ItsNotDaan/BodyTempSensor/Invertory BOM.xlsx

LCSC Part Number | Manufacture Part Number | Manufacturer | Customer NO. | Package | Description | RoHS | Quantity | Unit Price($) | Ext.Price($) | Estimated lead time (business days) | Updated lead time | Date Code / Lot No.
C881688 | A2547WRB-2X3P | CJT(Changjiang Connectors) |  | Through Hole,Right Angle,P=2.54mm | Connector Header 6 position 2.54mm Pitch 3A Right Angle -40‚ÑÉ~+105‚ÑÉ | YES | 5 | 0.5219 | 2.61
C2907295 | FRC0805J102 TS | FOJAN |  | 805 | 1kŒ© ¬±5% 125mW 0805 Thick Film Resistor | YES | 100 | 0.0013 | 0.13
C103210 | RTT03103JTP | RALEC |  | 603 | 10kŒ© ¬±5% 100mW 0603 Thick Film Resistor | YES | 100 | 0.0009 | 0.09
C381115 | DC-005-5A-2.5 | XKB Connectivity |  | Through Hole | Power Barrel Connector Jack 2.5mm ID 6.5mm OD Through Hole, Right Angle | YES | 5 | 0.2796 | 1.40
C908221 | DSR1M | FUXINSEMI |  | SOD-123 | Diode 1000V 1A Surface Mount SOD-123 | YES | 100 | 0.0069 | 0.69
C134191 | K8-5851E-N1 | Korean Hroparts Elec |  | Through Hole | Pushbutton Switch Rectangular Button Through Hole | YES | 10 | 0.1816 | 1.82
C440004 | FM21X102K501PXG | PSA(Prosperity Dielectrics) |  | 805 | 1nF ¬±10% 500V Ceramic Capacitor X7R 0805 | YES | 50 | 0.009 | 0.45
C82522 | MM1Z24 | ST(Semtech) |  | SOD-123 | Zener Diode Independent 24V 500mW Surface Mount SOD-123 | YES | 50 | 0.0167 | 0.84
C351450 | AMS1117-5.0S | UMW(Youtai Semiconductor Co., Ltd.) |  | SOT-89 | Linear Voltage Regulator IC Positive Fixed 1 Output SOT-89 | YES | 5 | 0.0711 | 0.36
C602037 | CL21A226MAYNNNE | Samsung Electro-Mechanics |  | 805 | 22uF ¬±20% 25V Ceramic Capacitor X5R 0805 | YES | 20 | 0.0235 | 0.47
C83054 | 0603B104K250CT | Walsin Tech Corp |  | 603 | 100nF ¬±10% 25V Ceramic Capacitor X7R 0603 | YES | 100 | 0.0018 | 0.18
C295917 | 0402B103J500CT | Walsin Tech Corp |  | 402 | 10nF ¬±5% 50V Ceramic Capacitor X7R 0402 | YES | 100 | 0.0015 | 0.15
C369599 | 30N06 | UMW(Youtai Semiconductor Co., Ltd.) |  | TO-252 | N-Channel 60V 30A 55W Surface Mount TO-252 | YES | 5 | 0.1744 | 0.87
C104211 | RTT05302JTP | RALEC |  | 805 | 3kŒ© ¬±5% 125mW 0805 Thick Film Resistor | YES | 100 | 0.0029 | 0.29
C75856 | LMT85LP | Texas Instruments |  | TO-92 | -50‚ÑÉ~+150‚ÑÉ ¬±2.7‚ÑÉ TO-92 Analog and Digital Output RoHS | YES | 5 | 0.9514 | 4.76
C14877 | ATMEGA328P-AU | Microchip Tech |  | TQFP-32(7x7) | AVR 8 Bit 20MHz 23 TQFP-32(7x7) Microcontrollers RoHS | YES | 10 | 30864 | 30.86
C125975 | UWT1V101MCL1GS | Nichicon |  | SMD,D6.3xL7.7mm | 100uF ¬±20% 35V Aluminum Electrolytic Capacitors 1000hrs@105‚ÑÉ | YES | 5 | 0.0733 | 0.37
C110703 | PESDMC2FD18VB | Shanghai Prisemi Elec |  | DFN1006-2 | 60VC Clamp 2.5A@8/20us Ipp ESD DIODE DFN1006-2 | YES | 10 | 0.0451 | 0.45
C2904521 | HoLTT0603-1/10W-4.7K-1% | Milliohm |  | 603 | 4.7kŒ© ¬±1% 100mW 0603 Thick Film Resistor | YES | 60 | 0.0302 | 1.81
C2976072 | WS2812C-2020-V1 | Worldsemi |  | SMD,2x2mm | SMD,2x2mm LED Addressable, Specialty RoHS | YES | 200 | 0.0669 | 13.38
C3017744 | SCR0603J470R | VO |  | 603 | 100mW 470Œ© 75V Thick Film Resistor ¬±200ppm/‚ÑÉ ¬±5% 0603 Chip Resistor - Surface Mount RoHS | YES | 100 | 0.0011 | 0.11
C3016353 | SCR0603F22K | VO |  | 603 | 100mW 22kŒ© 75V Thick Film Resistor ¬±100ppm/‚ÑÉ ¬±1% 0603 Chip Resistor - Surface Mount RoHS | YES | 100 | 0.0013 | 0.13
C223907 | TYPE-C-31-M-14 | Korean Hroparts Elec |  | SMD | USB-C (USB TYPE-C) Receptacle Connector 16 Position Surface Mount | YES | 20 | 0.4519 | 9.04
C965790 | XL-1005SURC | XINGLIGHT |  | 402 | Red 625nm LED Indication - Discrete 2.3V 0402 | YES | 100 | 0.0069 | 0.69
C105620 | CC0603JRNPO9BN220 | YAGEO |  | 603 | 22pF ¬±5% 50V Ceramic Capacitor NP0 0603 | YES | 100 | 0.0023 | 0.23
C69335 | CL10A475KA8NQNC | Samsung Electro-Mechanics |  | 603 | 4.7uF ¬±10% 25V Ceramic Capacitor X5R 0603 | YES | 40 | 0.0173 | 0.69
C424093 | MCP73831T-2ACI/OT | Microchip Tech |  | SOT-23-5 | 3.75V~6V Lithium Battery 1 550mA SOT-23-5 Battery Chargers ICs RoHS | YES | 10 | 0.6523 | 6.52
C56392 | 0402B104K250NT | FH (Guangdong Fenghua Advanced Tech) |  | 402 | 100nF ¬±10% 25V Ceramic Capacitor X7R 0402 | YES | 100 | 0.0012 | 0.12
C105873 | RC0402JR-075K1L | YAGEO |  | 402 | 5.1kŒ© ¬±5% 62.5mW 0402 Thick Film Resistor | YES | 100 | 0.0006 | 0.06
C107000 | CC0402JRNPO9BN200 | YAGEO |  | 402 | 20pF ¬±5% 50V Ceramic Capacitor NP0 0402 | YES | 100 | 0.001 | 0.10
C113791 | CC0402MRX5R6BB105 | YAGEO |  | 402 | 1uF ¬±20% 10V Ceramic Capacitor X5R 0402 | YES | 100 | 0.0026 | 0.26
C135262 | SMNR4020-2.2UH | SXN(Shun Xiang Nuo Elec) |  | SMD,4x4mm | 3.4A 2.2uH ¬±20% 3.4A 46mŒ© SMD,4x4mm Fixed Inductors RoHS | YES | 10 | 0.0499 | 0.50
C141836 | TLV62569DBVR | Texas Instruments |  | SOT-23-5 | 1.5MHz Step-down type Adjustable 600mV~5.5V 2A SOT-23-5 Voltage Regulators - DC DC Switching Regulators RoHS | YES | 10 | 0.051 | 0.51
C163810 | WR04X1002FTL | Walsin Tech Corp |  | 402 | 10kŒ© ¬±1% 62.5mW 0402 Thick Film Resistor | YES | 100 | 0.0006 | 0.06
C1660 | 0603CG3R3C500NT | FH (Guangdong Fenghua Advanced Tech) |  | 603 | 3.3pF 50V Ceramic Capacitor C0G 0603 | YES | 100 | 0.0027 | 0.27
C258501 | C1005NP0100JGTS | Darfon Elec |  | 402 | 10pF ¬±5% 50V Ceramic Capacitor NP0 0402 | YES | 100 | 0.0025 | 0.25
C2827654 | USBLC6-2SC6 | TECH PUBLIC |  | SOT-23-6 | 12VC Clamp 6A Ipp ESD DIODE SOT-23-6 | YES | 10 | 0.0307 | 0.31
C2843335 | W25Q16JVUXIQ | Winbond Elec |  | USON-8-EP(2x3) | 2.7V~3.6V 16Mbit 133MHz SPI USON-8-EP(2x3) Memory (ICs) RoHS | YES | 5 | 0.4069 | 2.03
C2885592 | X252040MMB4SI | YXC Crystal Oscillators |  | SMD2520-4P | Crystal 40MHz ¬±10ppm 10pF SMD2520-4P | YES | 10 | 0.0897 | 0.90
C2913194 | ESP32-S3R8 | Espressif Systems |  | QFN-56(7x7) | -74.2dBm 150Mbps 2.412GHz~2.484GHz 2.4GHz 3V~3.6V QFN-56(7x7) RF Transceiver ICs RoHS | YES | 5 | 35962 | 17.98
C2925417 | KH-3216-H0209 | Shenzhen Kinghelm Elec |  | 1206 | RF ANTENNA Patch Surface Mount 1206 | YES | 10 | 0.0467 | 0.47
C2976072 | WS2812C-2020-V1 | Worldsemi |  | SMD,2x2mm | SMD,2x2mm LED Addressable, Specialty RoHS | YES | 40 | 0.0662 | 2.65
C2992625 | 0402X106M100CT | Walsin Tech Corp |  | 402 | 10uF ¬±20% 10V Ceramic Capacitor X5R 0402 | YES | 30 | 0.0418 | 1.25
C370234 | SDCL1608C2N0STDF | Sunlord |  | - | - | - | 50 | 0.0078 | 0.39
C413049 | ERJ2RKF22R0X | PANASONIC |  | 402 | 22Œ© 100mW Thick Film Resistor ¬±100ppm/‚ÑÉ ¬±1% 0402 Chip Resistor - Surface Mount RoHS | YES | 100 | 0.0046 | 0.46
C512395 | EVQP2P02W | PANASONIC |  | SMD,4.7x3.5mm | Tactile Switch SPST 1N 2.5mm J-Lead 4.7mm x 3.5mm Surface Mount | YES | 20 | 0.2153 | 4.31
C705662 | RT0402CRE07100KL | YAGEO |  | 402 | 100kŒ© 62.5mW 50V Thin Film Resistor ¬±50ppm/‚ÑÉ ¬±0.25% 0402 Chip Resistor - Surface Mount RoHS | YES | 20 | 0.0287 | 0.57
C82453 | GRM155R60J475ME47D | Murata Electronics |  | 402 | 4.7uF ¬±20% 6.3V Ceramic Capacitor X5R 0402 | YES | 100 | 0.0055 | 0.55
C93232 | DST310S 32.768KHz | KDS Daishinku |  | SMD3215-2P | 12.5pF SMD3215-2P Crystals RoHS | YES | 5 | 0.2609 | 1.30
C3040637 | TPMCP1702T-5002E/MB | TECH PUBLIC |  | SOT-89-3 | 5V Positive Fixed SOT-89-3 Voltage Regulators - Linear, Low Drop Out (LDO) Regulators RoHS | YES | 10 | 0.233 | 2.33
C99269 | TMP102AIDRLR | Texas Instruments |  | SOT-563 | -40‚ÑÉ~+125‚ÑÉ I2C ¬±0.5‚ÑÉ SOT-563 Analog and Digital Output RoHS | YES | 5 | 0.2658 | 1.33
C141380 | PCA9557PW,118 | NXP Semicon |  | TSSOP-16 | 8 TSSOP-16 I/O Expanders RoHS | YES | 5 | 0.6425 | 3.21
C965818 | XL-2012UWC | XINGLIGHT |  | 805 | White LED Indication - Discrete 3.3V 0805 | YES | 50 | 0.0089 | 0.45
C2837587 | KH-BNC50-3511 | Shenzhen Kinghelm Elec |  | Through Hole | Connector Receptacle BNC Female Pin 50Œ© Through Hole Right Angle | YES | 5 | 0.8258 | 4.13
C193969 | ADS1015IDGSR | Texas Instruments |  | VSSOP-10-0.5mm | I2C 2V~5.5V VSSOP-10-0.5mm Analog to Digital Converters (ADC) RoHS | YES | 5 | 10388 | 5.19
C2761457 | AS0BC21-S48BE-7H | FOXCONN |  | SMD,P=0.5mm,Surface Mount,Right Angle | 67P Surface Mount, Right Angle SMD,P=0.5mm,Surface Mount,Right Angle Centronics Connectors RoHS | YES | 5 | 0.9805 | 4.90
C2761526 | AS0BC21-S40BB-7H | FOXCONN |  | SMD,P=0.5mm,Surface Mount,Right Angle | 67P Surface Mount, Right Angle SMD,P=0.5mm,Surface Mount,Right Angle Centronics Connectors RoHS | YES | 20 | 0.3079 | 6.16
C512395 | EVQP2P02W | PANASONIC |  | SMD,4.7x3.5mm | Tactile Switch SPST 1N 2.5mm J-Lead 4.7mm x 3.5mm Surface Mount | YES | 30 | 0.2288 | 6.86
C2827654 | USBLC6-2SC6 | TECH PUBLIC |  | SOT-23-6 | 12VC Clamp 6A Ipp ESD DIODE SOT-23-6 | YES | 10 | 0.0334 | 0.33
C144198 | MCP4725A0T-E/CH | MICROCHIP |  | SOT-23-6 | 6us 2.7V~5.5V 2LSB I2C SOT-23-6 Digital to Analog Converters (DAC) RoHS | YES | 3 | 0.8004 | 2.40
C7813 | SN74LVC125APWR | TI |  | TSSOP-14 | 1.65V~3.6V 1 4 2.5ns@3.3V,50pF 40uA TSSOP-14 Buffers, Drivers, Receivers, Transceivers RoHS | YES | 5 | 0.1412 | 0.71
C393941 | TF PUSH | SHOU HAN |  | SMD | Micro SD card (TF card) Connector and Ejector Push-Push Surface Mount | YES | 10 | 0.0509 | 0.51
C2765186 | TYPE-C 16PIN 2MD(073) | SHOU HAN |  | SMD | USB-C (USB TYPE-C) Receptacle Connector 16 Position Surface Mount, Right Angle | YES | 20 | 0.0505 | 1.01
C2976072 | WS2812C-2020-V1 | Worldsemi |  | SMD,2x2mm | SMD,2x2mm LED Addressable, Specialty RoHS | YES | 50 | 0.0528 | 2.64
