ItsNotDaan/BodyTempSensor/BodyTempSens_Data.xlsx

Sheet: Parameters
Component_Value | Component_Package | Component_Voltage | Component_Current | Component_Tolerance | Component_Type | Specifications | LCSC PART # | Manufacturer_Name
1u | 0603 | 25V |  | 10% | X5R | 25V 1uF X5R ±10% 0603 | C14664 | YAGEO
10u | 0603 | 25V |  | 10% | X5R | 25V 10uF X5R ±10% 0603 | C7500379 | YAGEO
4u7 | 0603 | 25V |  | 10% | X5R | 25V 4.7uF X5R ±10% 0603 | C326580 | YAGEO
10u | 0603 | 25V |  | 10% | X5R | 25V 10uF X5R ±10% 0603 | C7500379 | YAGEO
100n | 0603 | 50V |  | 10% | X7R | 50V 100nF X7R ±10% 0603 | C14663 | YAGEO
10u | 0603 | 25V |  | 10% | X5R | 25V 10uF X5R ±10% 0603 | C7500379 | YAGEO
1u | 0603 | 25V |  | 10% | X5R | 25V 1uF X5R ±10% 0603 | C14664 | YAGEO
1u | 0603 | 25V |  | 10% | X5R | 25V 1uF X5R ±10% 0603 | C14664 | YAGEO
100n | 0603 | 50V |  | 10% | X7R | 50V 100nF X7R ±10% 0603 | C14663 | YAGEO
100n | 0603 | 50V |  | 10% | X7R | 50V 100nF X7R ±10% 0603 | C14663 | YAGEO
17/6V 5A | SOT-23-6 | 5,25V | 5A |  |  | 5A 17V 6V Unidirectional 5.25V SOT-23-6 ESD and Surge Protection | C7519 | STMicroelectronics
40V 2A | SMA(DO-214AC) | 40V |  |  |  | 40V 550mV@2A Schottky Diode | C50645 | Microdiode Semiconductor
RED | 0603 |  | 20mA |  |  | 20mA 620nm~630nm Red 120° 50mW 2.3V 0603 LED | C965799 | XINGLIGHT
RED | 0603 |  | 20mA |  |  | 20mA 620nm~630nm Red 120° 50mW 2.3V 0603 LED | C965799 | XINGLIGHT
 | SOT-23-5 |  |  |  |  | Step-down type Adjustable 600mV~5.5V 2A 2.5V~5.5V | C141836 | Texas Instruments
 | SMD-53P |  |  |  |  |  | C5736265 | Espressif Systems
 | SMD-53P |  |  |  |  |  | C5736265 | Espressif Systems
 | SMD |  | 5A |  |  | 5A USB Sinking plate 16P Female Type-C | C2835313 | XUNPU
 |  |  |  |  |  |  |  | SAMTEC
 | 0,5mm
 | 0,5mm
 | 0,5mm
2u2 | 1008 |  | 1,3A | 20% |  | 1.3A 2.2uH ±20% | C86092 | Murata Electronics
RED | 0603 | 2,3V | 20mA |  |  | 20mA 620nm~630nm Red 120° 50mW 2.3V 0603 LED | C965799 | XINGLIGHT
RED | 0603 | 2,3V | 20mA |  |  | 20mA 620nm~630nm Red 120° 50mW 2.3V 0603 LED | C965799 | XINGLIGHT
5k1 | 0603 | 75V |  | 100ppm |  | 5k1Ω 0603 75V ±100ppm | C105580 | YAGEO
5k1 | 0603 | 75V |  | 100ppm |  | 5k1Ω 0603 75V ±100ppm | C105580 | YAGEO
470 | 0603 | 75V |  | 100ppm |  | 470Ω 0603 75V ±100ppm | C114669 | YAGEO
470 | 0603 | 75V |  | 100ppm |  | 470Ω 0603 75V ±100ppm | C114669 | YAGEO
453k | 0603 | 75V |  | ±1% |  | 453kΩ 0603 75V ±100ppm ±1% | C3013202 | UNI-ROYAL(Uniroyal Elec)
100k | 0603 | 75V |  | 100ppm |  | 100kΩ 0603 75V ±100ppm | C14675 | YAGEO
10k | 0603 | 75V |  | 100ppm |  | 10kΩ 0603 75V ±100ppm | C98220 | YAGEO
10k | 0603 | 75V |  | 100ppm |  | 10kΩ 0603 75V ±100ppm | C98220 | YAGEO
BTN | SMD | 12V | 50mA |  |  | 50mA 6mm 50,000 Times 260gf 12V 3.6mm 2.5mm | C318938 | XKB Connection
BTN | SMD | 12V | 50mA |  |  | 50mA 6mm 50,000 Times 260gf 12V 3.6mm 2.5mm | C318938 | XKB Connection
 | SMD,1x1mm |  |  |  |  | SMD,1x1mm RGB LEDs(Built-in IC) ROHS | C5349953 | XINGLIGHT

Sheet: Final Parameters
Identifier | Component_Value | Component_Voltage | Component_Current | Component_Tolerance | Component_Type | Specifications |  | LCSC PART # | Component_Package | Manufacturer_Name
C1 | 1u | 25V |  | 0.1 | X5R | 25V 1uF X5R ±10% 0603 | CC0603KRX5R8BB105 | C14664 | 0603 | YAGEO
C2 | 10u | 25V |  | 0.1 | X5R | 25V 10uF X5R ±10% 0603 | CC0603KRX5R8BB106 | C7500379 | 0603 | YAGEO
C3 | 4u7 | 25V |  | 0.1 | X5R | 25V 4.7uF X5R ±10% 0603 | CC0603KRX5R8BB475 | C326580 | 0603 | YAGEO
C4 | 10u | 25V |  | 0.1 | X5R | 25V 10uF X5R ±10% 0603 | CC0603KRX5R8BB106 | C7500379 | 0603 | YAGEO
C5 | 100n | 50V |  | 0.1 | X7R | 50V 100nF X7R ±10% 0603 | CC0603KRX7R9BB104 | C14663 | 0603 | YAGEO
C6 | 10u | 25V |  | 0.1 | X5R | 25V 10uF X5R ±10% 0603 | CC0603KRX5R8BB106 | C7500379 | 0603 | YAGEO
C7 | 1u | 25V |  | 0.1 | X5R | 25V 1uF X5R ±10% 0603 | CC0603KRX5R8BB105 | C14664 | 0603 | YAGEO
C8 | 1u | 25V |  | 0.1 | X5R | 25V 1uF X5R ±10% 0603 | CC0603KRX5R8BB105 | C14664 | 0603 | YAGEO
C9 | 100n | 50V |  | 0.1 | X7R | 50V 100nF X7R ±10% 0603 | CC0603KRX7R9BB104 | C14663 | 0603 | YAGEO
C10 | 100n | 50V |  | 0.1 | X7R | 50V 100nF X7R ±10% 0603 | CC0603KRX7R9BB104 | C14663 | 0603 | YAGEO
D1 | 17/6V 5A | 5,25V | 5A |  |  | 5A 17V 6V Unidirectional 5.25V SOT-23-6 ESD and Surge Protection | USBLC6-2SC6 | C7519 | SOT-23-6 | STMicroelectronics
D2 | 550mV | 40V | 2A |  |  | 40V 550mV@2A Schottky Diode | SS24 | C50645 | DO-214AC | Microdiode Semiconductor
D3 | RED |  | 20mA |  |  | 20mA 620nm~630nm Red 120° 50mW 2.3V 0603 LED | XL-1608SURC-06 | C965799 | 0603 | XINGLIGHT
D4 | RED |  | 20mA |  |  | 20mA 620nm~630nm Red 120° 50mW 2.3V 0603 LED | XL-1608SURC-06 | C965799 | 0603 | XINGLIGHT
IC1 |  |  |  |  |  | Step-down type Adjustable 600mV~5.5V 2A 2.5V~5.5V | TLV62569DBVR | C141836 | SOT-23-5 | Texas Instruments
IC2A |  |  |  |  |  | SMD-53P WiFi Modules ROHS | ESP32-C6-MINI-1-N4 | C5736265 | SMD-53P | Espressif Systems
IC2B |  |  |  |  |  | SMD-53P WiFi Modules ROHS | ESP32-C6-MINI-1-N4 | C5736265 | SMD-53P | Espressif Systems
J1 |  |  | 5A |  |  | 5A USB Sinking plate 16P Female Type-C | TYPEC-302-BRP16SC16 | C2835313 | SMD | XUNPU
J2 |  |  |  |  |  |  | SQW-104-01-F-D-VS-P |  |  | SAMTEC
JP1 |  |  |  |  |  |  |  |  | 0,5mm
JP2 |  |  |  |  |  |  |  |  | 0,5mm
JP3 |  |  |  |  |  |  |  |  | 0,5mm
L1 | 2u2 |  | 1,3A | 0.2 |  | 1.3A 2.2uH ±20% | LQM2HPN2R2MG0L | C86092 | 1008 | Murata Electronics
LED1 |  |  |  |  |  | SMD,1x1mm RGB LEDs(Built-in IC) ROHS | XL-1010RGBC-WS2812B | C5349953 | SMD,1x1mm | XINGLIGHT
LED2 |  |  |  |  |  | SMD,1x1mm RGB LEDs(Built-in IC) ROHS | XL-1010RGBC-WS2812B | C5349953 | SMD,1x1mm | XINGLIGHT
R1 | 5k1 | 75V |  | ±1% |  | 5k1Ω 0603 75V ±100ppm | RC0603FR-075K1L | C105580 | 0603 | YAGEO
R2 | 5k1 | 75V |  | ±1% |  | 5k1Ω 0603 75V ±100ppm | RC0603FR-075K1L | C105580 | 0603 | YAGEO
R3 | 470 | 75V |  | 100ppm |  | 470Ω 0603 75V ±100ppm | RC0603FR-07470RL | C114669 | 0603 | YAGEO
R4 | 470 | 75V |  | 100ppm |  | 470Ω 0603 75V ±100ppm | RC0603FR-07470RL | C114669 | 0603 | YAGEO
R5 | 453k | 75V |  | ±1% |  | 453kΩ 0603 75V ±100ppm ±1% | FRC0603F4533TS | C3013202 | 0603 | UNI-ROYAL(Uniroyal Elec)
R6 | 100k | 75V |  | 100ppm |  | 100kΩ 0603 75V ±100ppm | RC0603FR-07100KL | C14675 | 0603 | YAGEO
R7 | 10k | 75V |  | 100ppm |  | 10kΩ 0603 75V ±100ppm | RC0603FR-0710KL | C98220 | 0603 | YAGEO
R8 | 10k | 75V |  | 100ppm |  | 10kΩ 0603 75V ±100ppm | RC0603FR-0710KL | C98220 | 0603 | YAGEO
S1 |  | 12V | 50mA |  |  | 50mA 6mm 50,000 Times 260gf 12V 3.6mm 2.5mm | TS-1101-C-W | C318938 | SMD | XKB Connection
S2 |  | 12V | 50mA |  |  | 50mA 6mm 50,000 Times 260gf 12V 3.6mm 2.5mm | TS-1101-C-W | C318938 | SMD | XKB Connection
TP1
TP2
TP3
TP4
TP5
 |  |  |  |  |  | Power Rail: | Component name: | LCSC PART #
 |  |  |  |  |  | VBUS | USBLC6-2SC6 | C7519
 |  |  |  |  |  | VBUS | SS24 | C50645
 |  |  |  |  |  | 5V | XL-1608SURC-06 | C965799
 |  |  |  |  |  | 3V3 | XL-1608SURC-06 | C965799
 |  |  |  |  |  | Vbus to 3v3 | TLV62569DBVR | C141836
 |  |  |  |  |  | 3V3 | ESP32-C6-MINI-1-N4 | C5736265
 |  |  |  |  |  | 3V3 | XL-1010RGBC-WS2812B | C5349953
 |  |  |  |  |  | 3V3 | XL-1010RGBC-WS2812B | C5349953

Sheet: Power
Voltage Rail (V) | Part | Current (A) | TLV62569DBVR |  |  |  | Wrong Calculations |  |  |  |  |  |  |  |  | Correct Calculations
VBUS | USBLC6-2SC6 | - |  |  |  |  | Power Rail: | Component name: | Ityp | Imax | Pmax |  |  |  |  | Power Rail: | Component name: | Ityp | Imax | Pmax
5 | HLK-LD2410C | 0.20 | R2 calculation |  | IL(max) Formula |  | 5 | USBLC6-2SC6 | 0.01 |  | 0.00 | Rail Name | Voltage (V) | Load Typ | Load Max | 5 | USBLC6-2SC6 | 0.01 |  | 0.00 | Rail Name | Voltage (V) | Load Typ | Load Max
5 | HLK-LD2411 | 0.05 | Vfb | 0.6 | Fsw | 1500000 | 5 | SS24 | - |  | 0.00 | VBUS | 5 | 860mA | 1,18A | 5 | SS24 | - |  | 0.00 | VBUS | 5 | 670mA | 920A
5 | HLK-LD2450 | 0.03 | R2 | 100000 | L | 2.2e-06 | 5 | HLK-LD2450 | 0.20 | 0.30 |  | +5V | 5 | 860mA | 1,18A | 5 | HLK-LD2450 | 0.20 | 0.30 |  | +5V | 5 | 670mA | 920A |  | Start Values |  | Iin | 0.6038297872
5 | HLK-LD2420 | 0.10 | Vout | 3.3 | Vin | 5 | 5 | XL-1608SURC-06 | 0.02 | 0.02 | 0.10 | +3V3 | 3.3 | 640mA | 860mA | 5 | XL-1608SURC-06 | 0.02 | 0.02 | 0.10 | +3V3 | 3.3 | 640mA | 860mA |  | Name | Value
5 | ME73MS01 | 0.05 |  |  | Vout | 3.318 | 5 | TLV62569DBVR | 0.64 | 0.86 | 4.30 |  |  |  |  | 5 | TLV62569DBVR | 0.45 | 0.60 | 3.00 |  |  |  |  |  | Vin | 5
5 | DFRobot SEN0395 | 0.15 |  |  | IL(max) | 1.3 |  |  | 0.86 | 1.18 |  |  |  |  |  |  |  | 0.67 | 0.92 |  |  |  |  |  |  | Vout | 3.3
5 | WS2812C-2020-V1 | 0.06 |  |  |  |  |  |  |  |  |  |  |  |  |  |  |  |  |  |  |  |  |  |  |  | Iout | 0.86
5 | XL-1608SURC-06 | 0.02 | R1 = | 450000 |  |  | 3,3 | XL-1608SURC-06 | 0.02 | 0.02 | 0.07 |  |  |  |  | 3,3 | XL-1608SURC-06 | 0.02 | 0.02 | 0.07 |  |  |  |  |  | Efficiency | 94%
3.3 | ESP32-C6-MINI-1-N4 | 0.50 |  |  | Top | 5.580876 | 3,3 | ESP32-C6-MINI-1-N4 | 0.50 | 0.60 | 1.98 |  |  |  |  | 3,3 | ESP32-C6-MINI-1-N4 | 0.50 | 0.60 | 1.98 |  |  |  |  |  | Pin | 3.019148936
3.3 | MS72SF1 | 0.15 | Vout calculation] |  | Bottom | 16.5 | 3,3 | XL-1010RGBC-WS2812B | 0.06 | 0.12 | 0.40 |  |  |  |  | 3,3 | XL-1010RGBC-WS2812B | 0.06 | 0.12 | 0.40
 | TLV62569DBVR |  | Chosen R1: | 453000 | IL = | 0.3382349091 | 3,3 | XL-1010RGBC-WS2812B | 0.06 | 0.12 | 0.40 |  |  |  |  | 3,3 | XL-1010RGBC-WS2812B | 0.06 | 0.12 | 0.40 | TYPICAL LOAD |  |  |  |  |  |  |  |  | TYPICAL LOAD
 |  |  |  |  |  |  |  |  | 0.64 | 0.86 |  |  |  |  |  |  |  | 0.64 | 0.86 |  | OUT |  |  |  | IN |  |  |  |  | OUT |  |  |  | IN
 |  |  |  |  | Iout(max) Formula |  |  |  |  |  |  |  |  |  |  |  |  |  |  |  | Converter (VOUT) | Converter (IOUT) | Converter (POUT) | Efficiency (Datasheet) | Converter (VIN) | Converter (PIN) | Converter (I_IN Line) |  |  | Converter (VOUT) | Converter (IOUT) | Converter (POUT) | Efficiency (Datasheet) | Converter (VIN) | Converter (PIN) | Converter (I_IN Line)
 |  |  |  |  | IL(max) | 1.3 |  |  |  |  |  |  |  |  |  |  |  |  |  |  | 3.3V | 0.64A | 2.112W | 94.00% | 5.0V | 2.24681W | 0.44936A |  |  | 3.3V | 0.64A | 2.112W | 94.00% | 5.0V | 2.24681W | 0.44936A
 |  |  | Vout = | 3.318
 |  |  |  |  | IL = | 1.130882545 |  |  |  |  |  |  |  |  |  |  |  |  |  |  | MAX LOAD |  |  |  |  |  |  |  |  | MAX LOAD
 |  |  |  |  |  |  |  |  |  |  |  |  |  |  |  |  |  |  |  |  | OUT |  |  |  | IN |  |  |  |  | OUT |  |  |  | IN
 |  |  |  |  |  |  |  |  |  |  |  |  |  |  |  |  |  |  |  |  | Converter (VOUT) | Converter (IOUT) | Converter (POUT) | Efficiency (Datasheet) | Converter (VIN) | Converter (PIN) | Converter (I_IN Line) |  |  | Converter (VOUT) | Converter (IOUT) | Converter (POUT) | Efficiency (Datasheet) | Converter (VIN) | Converter (PIN) | Converter (I_IN Line)
 |  |  |  |  |  |  |  |  |  |  |  |  |  |  |  |  |  |  |  |  | 3.3V | 0.86A | 2.838W | 94.00% | 5.0V | 3.01915W | 0.60383A |  |  | 3.3V | 0.86A | 2.838W | 94.00% | 5.0V | 3.01915W | 0.60383A
 |  |  |  |  |  |  |  |  |  |  |  |  |  |  |  |  |  |  |  |  | Start Values
 |  |  |  |  |  |  |  |  |  |  |  |  |  |  |  |  |  |  |  |  | Name | Value
 |  |  |  |  |  |  |  |  |  |  |  |  |  |  |  |  |  |  |  |  | Vin | +5V
 |  |  |  |  |  |  |  |  |  |  |  |  |  |  |  |  |  |  |  |  | Vout | +3V3
 |  |  |  |  |  |  |  |  |  |  |  |  |  |  |  |  |  |  |  |  | Iout | 860mA
 |  |  |  |  |  |  |  |  |  |  |  |  |  |  |  |  |  |  |  |  | Efficiency | 90%
 |  |  |  |  |  |  |  |  |  |  |  |  |  |  |  |  |  |  |  |  | Pin | #VALUE!

Sheet: Sheet1
Name: | Typ: | Max: | Standby: | Battery capacity: | 0.5 |  | Typ: | Max: | Standby:
USB-C | 0 |  |  |  |  | Hours: | 60.78842588 | 32.6306859 | 3149.606299
MCP73833 | 2.5e-07 | 2e-06 | 2.5e-07 |  |  | Days: | 2.532851078 | 1.359611912 | 131.2335958
TLV62568DBVR | 3.5e-05 | 3.5e-05 | 3.5e-05
NRF52840-QIAA-F-R7 | 1.3e-05 | 2.6e-05 | 3e-06
MCP6001-OT | 0.00011 | 0.00016 | 0.00011 |  |  | Active: 8.23 mA × 1h = 8.23 mAh
WS2812C-2020-V1 | 0.008 | 0.015 | 1e-05 |  |  | Standby: 0.159 mA × 23h = 3.66 mAh
MAX30208CLB+T | 6.7e-05 | 0.0001 | 5e-07 |  |  | Total per day: ~12 mAh
 | Typ: | Max: | Standby: |  |  | Days: | 41.66666667
Total: | 0.00822525 | 0.015323 | 0.00015875
Battery: 3.7V 500mAh
Name: | Typ: | Max: | Standby: | Battery capacity: | 0.5 |  | Typ: | Max: | Standby:
USB-C | 0 |  |  |  |  | Hours: | 2219.755827 | 32.6306859 | 9302.325581
MCP73833 | 2.5e-07 | 2e-06 | 2.5e-07 |  |  | Days: | 92.48982612 | 1.359611912 | 387.5968992
TLV62568DBVR | 3.5e-05 | 3.5e-05 | 3.5e-05
NRF52840-QIAA-F-R7 | 1.3e-05 | 2.6e-05 | 3e-06
MCP6001-OT | 1e-05 | 0.00016 | 1e-05 |  |  | Active: 8.23 mA × 1h = 8.23 mAh
WS2812C-2020-V1 | 0.0001 | 0.015 | 5e-06 |  |  | Standby: 0.159 mA × 23h = 3.66 mAh
MAX30208CLB+T | 6.7e-05 | 0.0001 | 5e-07 |  |  | Total per day: ~12 mAh
 | Typ: | Max: | Standby: |  |  | Days: | 41.66666667
Total: | 0.00022525 | 0.015323 | 5.375e-05
Battery: 3.7V 500mAh

Sheet: Pricelist
Body Temperature Sensor — Pricelist (LCSC)
Source: lcsc.com — prices as of Jun 2026, unit price at qty 1. Source URLs in cell comments.
Line # | MPN | Description | LCSC Part # | Qty | Unit Price (USD) | Extended Price (USD) | In Stock? | Notes
1 | CC0402KRX5R6BB104 | 100nF 0402 MLCC | C129131 | 21 | €0.0010 | €0.0210 | Yes | YAGEO, 10V X5R
2 | CC0402KRX5R8BB105 | 1µF 0402 MLCC | C326568 | 7 | €0.0020 | €0.0140 | Yes | YAGEO, 25V X5R
3 | USBLC6-2SC6 | ESD protection | C7519 | 1 | €0.0780 | €0.0780 | Yes | ST, SOT-23-6, 45,720 pcs
4 | USB4105-GF-A | USB-C receptacle | C3020560 | 1 | €0.5480 | €0.5480 | Yes | GCT, 16P top-mount
5 | 52271-0479 | 1mm FPC 4-ckt connector | N/A | 1 | €0.0000 | €0.0000 | No (LCSC) | ⚠ Not at LCSC — order from Mouser/Digi-Key
6 | SMNR4020-2.2UH | 2.2µH 4020 inductor (alt) | C135262 | 1 | €0.0250 | €0.0250 | Yes | Alt for Würth 74404020022 (same 4020 pkg, 2.2µH)
7 | RC0402FR-0710KL | 10kΩ 0402 resistor | C60490 | 8 | €0.0005 | €0.0040 | Yes | YAGEO 1%, 709,100 pcs
8 | EVQP2B02B | Tactile switch | C713480 | 1 | €0.7950 | €0.7950 | Yes | Panasonic EVQP2, 1,317 pcs
9 | NRF52840-QIAA-R | nRF52840 BLE SoC | C190794 | 1 | €4.1500 | €4.1500 | Yes | Nordic, AQFN-73
10 | TMP117MAIDRVR | Precision temp sensor | C2803242 | 1 | €1.0300 | €1.0300 | Yes | TI, 2,450 pcs; T-suffix OOS → use R-suffix
11 | MCP73833-AMI/UN | Li-Ion charger | C511281 | 1 | €0.0000 | €0.0000 | No (LCSC) | ⚠ OOS at LCSC — order from Mouser/Digi-Key (~$0.60)
12 | TLV62568DBVR | Buck converter 1A | C163219 | 1 | €0.3500 | €0.3500 | Yes | TI, SOT-23-5
13 | MCP6001T-I/OT | Op-amp single | C116490 | 1 | €0.1230 | €0.1230 | Yes | Microchip, 23,160 pcs
14 | X322525MOB4SI | Crystal 32MHz 3225 | C9006 | 1 | €0.0370 | €0.0370 | Yes | YXC, SMD-3225 4P
15 | WS2812C-2020-V1 | RGB LED addressable | C2976072 | 1 | €0.0550 | €0.0550 | Yes | Worldsemi, 204,310 pcs
TOTAL (LCSC-sourced lines only) |  |  |  |  |  | €7.2300
TOTAL (all lines, unit qty) |  |  |  |  |  | €7.2300

Sheet: BOM
Reference | Qty | Value | Footprint | Datasheet | LCSC PART # | Manufacturer_Name | Manufacturer_Part_Number | Description | Gecheckt | LCSC Voorraad / Prijs (USD)
ACT1 | 1 | SW_ACT | PCB_Lib_ItsNotDaan:SW_SPST_EVQP2 |  | C512395 | PANASONIC | EVQP2P02W | 20mA 4.7mm 100MŒ© 1,000,000 Times 1N 15V 3.5mm 2.5mm Rectangle button | Ja | C512395 | 174k stk | $0.11
ANT1 | 1 | KH-3216-H0209 | PCB_Lib_ItsNotDaan:ANTC3216X140N | https://www.johansontechnology.com/datasheets/2450AT18B100/2450AT18B100.pdf | C2925417 | Shenzhen Kinghelm Elec | KH-3216-H0209 | 1206 Antennas | Ja | C2925417 | op voorraad | $0.06
C1 | 1 | 1u | Capacitor_SMD:C_0402_1005Metric_Pad0.74x0.62mm_HandSolder |  | C113791 | KDS Daishinku | CC0402MRX5R6BB105 | 10V 1uF X5R ¬±20% 0403 | Ja | C113791 | 500k+ stk | $0.003
C11,C17 | 2 | 4u7 | Capacitor_SMD:C_0402_1005Metric_Pad0.74x0.62mm_HandSolder |  | C82453 | Murata Electronics | GRM155R60J475ME47D | 6.3V 4.7uF X5R ¬±20% 0402 | Ja | C82453 | 100k+ stk | $0.007
C18 | 1 | 390n | Capacitor_SMD:C_0402_1005Metric_Pad0.74x0.62mm_HandSolder |  |  |  |  |  | Nee | Niet op LCSC — zoek 0402 390nF X5R elders
C19 | 1 | 10u | Capacitor_SMD:C_0402_1005Metric_Pad0.74x0.62mm_HandSolder |  | C2992625 | FH (Guangdong Fenghua Advanced Tech) | 0402X106M100CT | 10V 10uF X5R ¬±20% 0402 | Ja | C2992625 | 300k+ stk | $0.005
C2 | 1 | 1u | Capacitor_SMD:C_0504_1310Metric_Pad0.83x1.28mm_HandSolder |  |  |  |  | Unpolarized capacitor | Nee | Niet op LCSC — zie KiCad voetafdruk
C27 | 1 | 10n | Capacitor_SMD:C_0402_1005Metric_Pad0.74x0.62mm_HandSolder |  |  |  |  | 25V 10nF X5R ¬±10% 0402 | Ja | C295917 | 1M+ stk | $0.0006
C28,C30 | 2 | 2u2 | Capacitor_SMD:C_0402_1005Metric_Pad0.74x0.62mm_HandSolder |  | C295941 | Walsin Tech Corp | 0402X225K100CT | 2.2uF ±10% 10V X5R 0402 | Nee | C295941 | op voorraad | $0.006
C29 | 1 | 2n2 | Capacitor_SMD:C_0402_1005Metric_Pad0.74x0.62mm_HandSolder |  | C106861 | YAGEO | CC0402KRX7R9BB222 | 2.2nF ±10% 50V X7R 0402 | Nee | C106861 | op voorraad | $0.0015
C3,C5,C7,C10,C12,C14,C22,C23,C24,C25,C26 | 11 | 100n | Capacitor_SMD:C_0402_1005Metric_Pad0.74x0.62mm_HandSolder |  | C361203 | YAGEO | C1005X5R1E104KT000E | 25V 100nF X5R ¬±10% 0402 | Ja | C361203 | op voorraad | $0.003
C4 | 1 | 1p5 | Capacitor_SMD:C_0402_1005Metric_Pad0.74x0.62mm_HandSolder |  |  |  |  | 50V 1.5pF 0402 | Nee | Niet op LCSC — 1.5pF NP0 0402 zeldzaam
C6,C9 | 2 | 12p | Capacitor_SMD:C_0402_1005Metric_Pad0.74x0.62mm_HandSolder |  | C106201 | YAGEO | CC0402JRNPO9BN120 | 12pF ±5% 50V NP0 0402 | Nee | C106201 | op voorraad | $0.0006
C8 | 1 | 2p | Capacitor_SMD:C_0402_1005Metric_Pad0.74x0.62mm_HandSolder |  | CC0402BRNPO9BN2R0 | YAGEO | CC0402BRNPO9BN2R0 | 2pF ±0.1pF 50V NP0 0402 (niet op LCSC, zie Farnell) | Nee | Geen LCSC C# — bestellen bij Farnell/TME
D1,D2,D3 | 3 | LED | LED_SMD:LED_0603_1608Metric_Pad1.05x0.95mm_HandSolder |  |  |  |  | Light emitting diode | Nee | C965790 | op voorraad | $0.006
IC3 | 1 | TMP117MAIDRVR | LibLoader:SON65P200X200X80-7N | http://www.ti.com/lit/ds/symlink/tmp117.pdf | C2803242 | Texas Instruments | TMP117MAIDRVR | ±0.1°C I2C WSON-6-EP(2x2) Temperature Sensor | Nee | C2803242 | 287 stk | $1.03
IC4,IC5,IC6 | 3 | TMP117MAIDRVT | LibLoader:SON65P200X200X80-7N | http://www.ti.com/lit/ds/symlink/tmp117.pdf | C2803242 | Texas Instruments | TMP117MAIDRVR | ±0.1°C I2C WSON-6-EP(2x2) Temperature Sensor (MAIDRVT obsoleet) | Nee | C2803242 | 287 stk | $1.03 (MAIDRVT obsoleet)
IC7 | 1 | NRF54L15-QFAA-R | LibLoader:QFN40P600X600X95-49N | https://docs-be.nordicsemi.com/bundle/ps_nrf54L15/page/pdf/nRF54L15_nRF54L10_nRF54L05_Datasheet_v0.8.pdf | C42458750 | Nordic Semiconductor | NRF54L15-QFAA-R | 2.4GHz BLE/Thread/Zigbee SoC QFN-48 1.5MB NVM | Nee | C42458750 | op voorraad | $2.36
J1 | 1 | USB_C_Receptacle_USB2.0 | Connector_USB:USB_C_Receptacle_GCT_USB4105-xx-A_16P_TopMnt_Horizontal | https://www.usb.org/sites/default/files/documents/usb_type-c.zip | C223907 |  |  | USB 2.0-only Type-C Receptacle connector | Nee | C223907 | op voorraad | $0.10
J2 | 1 | TC2030 | Connector:Tag-Connect_TC2030-IDC-NL_2x03_P1.27mm_Vertical | https://www.tag-connect.com/wp-content/uploads/bsk-pdf-manager/2019/12/TC2030-IDC-NL-Datasheet-Rev-B.pdf |  |  |  | Tag-Connect‚Äôs 6-pins connector | Nee | TC2030 — order bij Digikey/Mouser
J3 | 1 | BAT | Connector_PinSocket_2.54mm:PinSocket_1x02_P2.54mm_Vertical |  |  |  |  | Generic connector, single row, 01x02, script generated (kicad-library-utils/schlib/autogen/connector/) | Nee | BAT connector — type onbekend
J6 | 1 | Conn_02x05_Odd_Even | Connector_PinHeader_1.27mm:PinHeader_2x05_P1.27mm_Vertical |  |  |  |  | Generic connector, double row, 02x05, odd/even pin numbering scheme (row 1 odd numbers, row 2 even numbers), script generated (kicad-library-utils/schlib/autogen/connector/) | Nee | Conn 2x5 — type onbekend
L1,L4 | 2 | 3.5nH | Inductor_SMD:L_0201_0603Metric |  |  |  | LQP03HQ3N5B02 | 3.5 nH 0402 | Nee | 3.5nH inductor — niet op LCSC
L2 | 1 | 2u2 | Inductor_SMD_Wurth:L_Wurth_WE-LQSH-4020 |  | C135262 | SXN(Shun Xiang Nuo Elec) | SMNR4020-2.2UH | 3.4A 2.2uH ¬±20% 3.4A SMD,4x4x2mm Power Inductors ROHS | Ja | C135262 | op voorraad | $0.08
L3 | 1 | 2.7nH | Inductor_SMD:L_0201_0603Metric |  |  |  | LQP03HQ2N7B02 | 2.7 nH 0402 | Nee | 2.7nH inductor — niet op LCSC
L5 | 1 | 4u7 | Inductor_SMD:L_0201_0603Metric |  |  |  |  | 4.7 nH 0402 | Nee | 4.7uH inductor — niet op LCSC
LED1 | 1 | WS2812C-2020-V1 | PCB_Lib_ItsNotDaan:WS2812C2020 | http://www.world-semi.com/DownLoadFile/139 | C2976072 | Worldsemi | WS2812C-2020 | Intelligent control LED integrated light source | Ja | C2976072 | 500k+ stk | $0.009
Q1,Q2 | 2 | NMOS |  | https://ngspice.sourceforge.io/docs/ngspice-html-manual/manual.xhtml#cha_MOSFETs | C20917 | AOS | AO3400A | 30V 5.7A N-ch MOSFET SOT-23 | Nee | C20917 | 174k stk | $0.04
R1,R2,R26,R27 | 4 | 5k1 | Resistor_SMD:R_0402_1005Metric_Pad0.72x0.64mm_HandSolder |  | C105873 |  |  | Resistor | Ja | C105873 | 300k+ stk | $0.0005
R11 | 1 | 68k | Resistor_SMD:R_0402_1005Metric_Pad0.72x0.64mm_HandSolder |  | C238338 | YAGEO | RC0402FR-0768KL | 68kΩ ±1% 62.5mW 0402 Thick Film Resistor | Nee | C238338 | op voorraad | $0.0005
R13,R14,R19 | 3 | 100k | Resistor_SMD:R_0402_1005Metric_Pad0.72x0.64mm_HandSolder |  | C705662 | YAGEO | RT0402CRE07100KL | 100kŒ© 0402 50V ¬±50ppm | Ja | C705662 | op voorraad | $0.0005
R17 | 1 | 82k | Resistor_SMD:R_0402_1005Metric_Pad0.72x0.64mm_HandSolder |  | C137932 | YAGEO | RC0402FR-0782KL | 82kΩ ±1% 62.5mW 0402 Thick Film Resistor | Nee | C137932 | 142k stk | $0.0003
R18 | 1 | 450k | Resistor_SMD:R_0402_1005Metric_Pad0.72x0.64mm_HandSolder |  | C5159688 | FOJAN | FRC0402F4503TS | 450kŒ© 0402 50V 62,5mW ¬±100ppm | Ja | C5159688 | op voorraad | $0.003
R21,R23,R28 | 3 | 180k | Resistor_SMD:R_0402_1005Metric_Pad0.72x0.64mm_HandSolder |  | C138046 | YAGEO | RC0402FR-07180KL | 180kΩ ±1% 62.5mW 0402 Thick Film Resistor | Nee | C138046 | op voorraad | $0.0006
R22 | 1 | 47k | Resistor_SMD:R_0402_1005Metric_Pad0.72x0.64mm_HandSolder |  | C93943 | YAGEO | RC0402FR-0747KL | 47kΩ ±1% 62.5mW 0402 Thick Film Resistor | Nee | C93943 | 1,376k stk | $0.0003
R3,R12 | 2 | 22R | Resistor_SMD:R_0402_1005Metric_Pad0.72x0.64mm_HandSolder |  | C413049 | Espressif Systems | ERJ2RKF22R0X | 22Œ© 0402 50V 100mW ¬±100ppm | Ja | C413049 | op voorraad | $0.004
R4,R5,R6 | 3 | 470 | Resistor_SMD:R_0402_1005Metric_Pad0.72x0.64mm_HandSolder |  | C3017744 | VO | SCR0603J470R | 470Ω ±5% 100mW 0603 (uit inventory) | Nee | C3017744 | op voorraad | $0.002
R8,R10,R20,R25 | 4 | 10k | Resistor_SMD:R_0402_1005Metric_Pad0.72x0.64mm_HandSolder |  | C163810 | Walsin Tech Corp | WR04X1002FTL | 10kŒ© 0402 50V 62,5mW ¬±100ppm | Ja | C163810 | op voorraad | $0.0005
R9 | 1 | 1k | Resistor_SMD:R_0402_1005Metric_Pad0.72x0.64mm_HandSolder |  | C106235 | YAGEO | RC0402FR-071KL | 1kΩ ±1% 62.5mW 0402 Thick Film Resistor | Nee | C106235 | 597k stk | $0.0005
TP1,TP2,TP3,TP4 | 4 | TestPoint | TestPoint:TestPoint_Pad_D1.0mm |  |  |  |  | test point | Nee | Testpunten — geen component nodig
U2 | 1 | USBLC6-2SC6 | Package_TO_SOT_SMD:SOT-23-6 | https://www.st.com/resource/en/datasheet/usblc6-2.pdf | C2827654 |  |  | Very low capacitance ESD protection diode, 2 data-line, SOT-23-6 | Ja | C2827654 | op voorraad | $0.007
U3 | 1 | MCP73833-xxx-UN | Package_SO:MSOP-10_3x3mm_P0.5mm | https://ww1.microchip.com/downloads/aemDocuments/documents/OTH/ProductDocuments/DataSheets/22005b.pdf | C424093 |  |  | Stand-Alone Linear Li-Ion / Li-Polymer Charge Management Controller, MSOP-10 | Ja | C424093 | op voorraad | $0.09
U4 | 1 | TLV62568DBVR | Package_TO_SOT_SMD:SOT-23-5 | http://www.ti.com/lit/ds/symlink/tlv62568.pdf | C163219 | Texas Instruments | TLV62568DBVR | 5.5V 1A SOT-23-5 DC-DC Converters RoHS | Ja | C163219 | op voorraad | $0.06
U5 | 1 | MCP6001-OT | Package_TO_SOT_SMD:SOT-23-5 | https://ww1.microchip.com/downloads/en/DeviceDoc/MCP6001-1R-1U-2-4-1-MHz-Low-Power-Op-Amp-DS20001733L.pdf | C116490 | Microchip | MCP6001T-I/OT | 1MHz 1.8V~6V Single Op-Amp SOT-23-5 | Nee | C116490 | 77k stk | $0.12
Y1 | 1 | 32MHz | Crystal:Crystal_SMD_3225-4Pin_3.2x2.5mm |  | C113671 | YXC | X322532MMB4SI | 32MHz ±10ppm 10pF SMD3225-4P Crystal | Nee | C113671 | op voorraad | $0.037

Sheet: Inventory
LCSC Part Number | Manufacture Part Number | Manufacturer | Customer NO. | Package | Description | RoHS | Quantity | Unit Price($) | Ext.Price($) | Estimated lead time (business days) | Updated lead time | Date Code / Lot No.
C881688 | A2547WRB-2X3P | CJT(Changjiang Connectors) |  | Through Hole,Right Angle,P=2.54mm | Connector Header 6 position 2.54mm Pitch 3A Right Angle -40‚ÑÉ~+105‚ÑÉ | YES | 5 | 0.5219 | 2.61
C2907295 | FRC0805J102 TS | FOJAN |  | 805 | 1kŒ© ¬±5% 125mW 0805 Thick Film Resistor | YES | 100 | 0.0013 | 0.13
C103210 | RTT03103JTP | RALEC |  | 603 | 10kŒ© ¬±5% 100mW 0603 Thick Film Resistor | YES | 100 | 0.0009 | 0.09
C381115 | DC-005-5A-2.5 | XKB Connectivity |  | Through Hole | Power Barrel Connector Jack 2.5mm ID 6.5mm OD Through Hole, Right Angle | YES | 5 | 0.2796 | 1.40
C908221 | DSR1M | FUXINSEMI |  | SOD-123 | Diode 1000V 1A Surface Mount SOD-123 | YES | 100 | 0.0069 | 0.69
C134191 | K8-5851E-N1 | Korean Hroparts Elec |  | Through Hole | Pushbutton Switch Rectangular Button Through Hole | YES | 10 | 0.1816 | 1.82
C440004 | FM21X102K501PXG | PSA(Prosperity Dielectrics) |  | 805 | 1nF ¬±10% 500V Ceramic Capacitor X7R 0805 | YES | 50 | 0.009 | 0.45
C82522 | MM1Z24 | ST(Semtech) |  | SOD-123 | Zener Diode Independent 24V 500mW Surface Mount SOD-123 | YES | 50 | 0.0167 | 0.84
C351450 | AMS1117-5.0S | UMW(Youtai Semiconductor Co., Ltd.) |  | SOT-89 | Linear Voltage Regulator IC Positive Fixed 1 Output SOT-89 | YES | 5 | 0.0711 | 0.36
C602037 | CL21A226MAYNNNE | Samsung Electro-Mechanics |  | 805 | 22uF ¬±20% 25V Ceramic Capacitor X5R 0805 | YES | 20 | 0.0235 | 0.47
C83054 | 0603B104K250CT | Walsin Tech Corp |  | 603 | 100nF ¬±10% 25V Ceramic Capacitor X7R 0603 | YES | 100 | 0.0018 | 0.18
C295917 | 0402B103J500CT | Walsin Tech Corp |  | 402 | 10nF ¬±5% 50V Ceramic Capacitor X7R 0402 | YES | 100 | 0.0015 | 0.15
C369599 | 30N06 | UMW(Youtai Semiconductor Co., Ltd.) |  | TO-252 | N-Channel 60V 30A 55W Surface Mount TO-252 | YES | 5 | 0.1744 | 0.87
C104211 | RTT05302JTP | RALEC |  | 805 | 3kŒ© ¬±5% 125mW 0805 Thick Film Resistor | YES | 100 | 0.0029 | 0.29
C75856 | LMT85LP | Texas Instruments |  | TO-92 | -50‚ÑÉ~+150‚ÑÉ ¬±2.7‚ÑÉ TO-92 Analog and Digital Output RoHS | YES | 5 | 0.9514 | 4.76
C14877 | ATMEGA328P-AU | Microchip Tech |  | TQFP-32(7x7) | AVR 8 Bit 20MHz 23 TQFP-32(7x7) Microcontrollers RoHS | YES | 10 | 30864 | 30.86
C125975 | UWT1V101MCL1GS | Nichicon |  | SMD,D6.3xL7.7mm | 100uF ¬±20% 35V Aluminum Electrolytic Capacitors 1000hrs@105‚ÑÉ | YES | 5 | 0.0733 | 0.37
C110703 | PESDMC2FD18VB | Shanghai Prisemi Elec |  | DFN1006-2 | 60VC Clamp 2.5A@8/20us Ipp ESD DIODE DFN1006-2 | YES | 10 | 0.0451 | 0.45
C2904521 | HoLTT0603-1/10W-4.7K-1% | Milliohm |  | 603 | 4.7kŒ© ¬±1% 100mW 0603 Thick Film Resistor | YES | 60 | 0.0302 | 1.81
C2976072 | WS2812C-2020-V1 | Worldsemi |  | SMD,2x2mm | SMD,2x2mm LED Addressable, Specialty RoHS | YES | 200 | 0.0669 | 13.38
C3017744 | SCR0603J470R | VO |  | 603 | 100mW 470Œ© 75V Thick Film Resistor ¬±200ppm/‚ÑÉ ¬±5% 0603 Chip Resistor - Surface Mount RoHS | YES | 100 | 0.0011 | 0.11
C3016353 | SCR0603F22K | VO |  | 603 | 100mW 22kŒ© 75V Thick Film Resistor ¬±100ppm/‚ÑÉ ¬±1% 0603 Chip Resistor - Surface Mount RoHS | YES | 100 | 0.0013 | 0.13
C223907 | TYPE-C-31-M-14 | Korean Hroparts Elec |  | SMD | USB-C (USB TYPE-C) Receptacle Connector 16 Position Surface Mount | YES | 20 | 0.4519 | 9.04
C965790 | XL-1005SURC | XINGLIGHT |  | 402 | Red 625nm LED Indication - Discrete 2.3V 0402 | YES | 100 | 0.0069 | 0.69
C105620 | CC0603JRNPO9BN220 | YAGEO |  | 603 | 22pF ¬±5% 50V Ceramic Capacitor NP0 0603 | YES | 100 | 0.0023 | 0.23
C69335 | CL10A475KA8NQNC | Samsung Electro-Mechanics |  | 603 | 4.7uF ¬±10% 25V Ceramic Capacitor X5R 0603 | YES | 40 | 0.0173 | 0.69
C424093 | MCP73831T-2ACI/OT | Microchip Tech |  | SOT-23-5 | 3.75V~6V Lithium Battery 1 550mA SOT-23-5 Battery Chargers ICs RoHS | YES | 10 | 0.6523 | 6.52
C56392 | 0402B104K250NT | FH (Guangdong Fenghua Advanced Tech) |  | 402 | 100nF ¬±10% 25V Ceramic Capacitor X7R 0402 | YES | 100 | 0.0012 | 0.12
C105873 | RC0402JR-075K1L | YAGEO |  | 402 | 5.1kŒ© ¬±5% 62.5mW 0402 Thick Film Resistor | YES | 100 | 0.0006 | 0.06
C107000 | CC0402JRNPO9BN200 | YAGEO |  | 402 | 20pF ¬±5% 50V Ceramic Capacitor NP0 0402 | YES | 100 | 0.001 | 0.10
C113791 | CC0402MRX5R6BB105 | YAGEO |  | 402 | 1uF ¬±20% 10V Ceramic Capacitor X5R 0402 | YES | 100 | 0.0026 | 0.26
C135262 | SMNR4020-2.2UH | SXN(Shun Xiang Nuo Elec) |  | SMD,4x4mm | 3.4A 2.2uH ¬±20% 3.4A 46mŒ© SMD,4x4mm Fixed Inductors RoHS | YES | 10 | 0.0499 | 0.50
C141836 | TLV62569DBVR | Texas Instruments |  | SOT-23-5 | 1.5MHz Step-down type Adjustable 600mV~5.5V 2A SOT-23-5 Voltage Regulators - DC DC Switching Regulators RoHS | YES | 10 | 0.051 | 0.51
C163810 | WR04X1002FTL | Walsin Tech Corp |  | 402 | 10kŒ© ¬±1% 62.5mW 0402 Thick Film Resistor | YES | 100 | 0.0006 | 0.06
C1660 | 0603CG3R3C500NT | FH (Guangdong Fenghua Advanced Tech) |  | 603 | 3.3pF 50V Ceramic Capacitor C0G 0603 | YES | 100 | 0.0027 | 0.27
C258501 | C1005NP0100JGTS | Darfon Elec |  | 402 | 10pF ¬±5% 50V Ceramic Capacitor NP0 0402 | YES | 100 | 0.0025 | 0.25
C2827654 | USBLC6-2SC6 | TECH PUBLIC |  | SOT-23-6 | 12VC Clamp 6A Ipp ESD DIODE SOT-23-6 | YES | 10 | 0.0307 | 0.31
C2843335 | W25Q16JVUXIQ | Winbond Elec |  | USON-8-EP(2x3) | 2.7V~3.6V 16Mbit 133MHz SPI USON-8-EP(2x3) Memory (ICs) RoHS | YES | 5 | 0.4069 | 2.03
C2885592 | X252040MMB4SI | YXC Crystal Oscillators |  | SMD2520-4P | Crystal 40MHz ¬±10ppm 10pF SMD2520-4P | YES | 10 | 0.0897 | 0.90
C2913194 | ESP32-S3R8 | Espressif Systems |  | QFN-56(7x7) | -74.2dBm 150Mbps 2.412GHz~2.484GHz 2.4GHz 3V~3.6V QFN-56(7x7) RF Transceiver ICs RoHS | YES | 5 | 35962 | 17.98
C2925417 | KH-3216-H0209 | Shenzhen Kinghelm Elec |  | 1206 | RF ANTENNA Patch Surface Mount 1206 | YES | 10 | 0.0467 | 0.47
C2976072 | WS2812C-2020-V1 | Worldsemi |  | SMD,2x2mm | SMD,2x2mm LED Addressable, Specialty RoHS | YES | 40 | 0.0662 | 2.65
C2992625 | 0402X106M100CT | Walsin Tech Corp |  | 402 | 10uF ¬±20% 10V Ceramic Capacitor X5R 0402 | YES | 30 | 0.0418 | 1.25
C370234 | SDCL1608C2N0STDF | Sunlord |  | - | - | - | 50 | 0.0078 | 0.39
C413049 | ERJ2RKF22R0X | PANASONIC |  | 402 | 22Œ© 100mW Thick Film Resistor ¬±100ppm/‚ÑÉ ¬±1% 0402 Chip Resistor - Surface Mount RoHS | YES | 100 | 0.0046 | 0.46
C512395 | EVQP2P02W | PANASONIC |  | SMD,4.7x3.5mm | Tactile Switch SPST 1N 2.5mm J-Lead 4.7mm x 3.5mm Surface Mount | YES | 20 | 0.2153 | 4.31
C705662 | RT0402CRE07100KL | YAGEO |  | 402 | 100kŒ© 62.5mW 50V Thin Film Resistor ¬±50ppm/‚ÑÉ ¬±0.25% 0402 Chip Resistor - Surface Mount RoHS | YES | 20 | 0.0287 | 0.57
C82453 | GRM155R60J475ME47D | Murata Electronics |  | 402 | 4.7uF ¬±20% 6.3V Ceramic Capacitor X5R 0402 | YES | 100 | 0.0055 | 0.55
C93232 | DST310S 32.768KHz | KDS Daishinku |  | SMD3215-2P | 12.5pF SMD3215-2P Crystals RoHS | YES | 5 | 0.2609 | 1.30
C3040637 | TPMCP1702T-5002E/MB | TECH PUBLIC |  | SOT-89-3 | 5V Positive Fixed SOT-89-3 Voltage Regulators - Linear, Low Drop Out (LDO) Regulators RoHS | YES | 10 | 0.233 | 2.33
C99269 | TMP102AIDRLR | Texas Instruments |  | SOT-563 | -40‚ÑÉ~+125‚ÑÉ I2C ¬±0.5‚ÑÉ SOT-563 Analog and Digital Output RoHS | YES | 5 | 0.2658 | 1.33
C141380 | PCA9557PW,118 | NXP Semicon |  | TSSOP-16 | 8 TSSOP-16 I/O Expanders RoHS | YES | 5 | 0.6425 | 3.21
C965818 | XL-2012UWC | XINGLIGHT |  | 805 | White LED Indication - Discrete 3.3V 0805 | YES | 50 | 0.0089 | 0.45
C2837587 | KH-BNC50-3511 | Shenzhen Kinghelm Elec |  | Through Hole | Connector Receptacle BNC Female Pin 50Œ© Through Hole Right Angle | YES | 5 | 0.8258 | 4.13
C193969 | ADS1015IDGSR | Texas Instruments |  | VSSOP-10-0.5mm | I2C 2V~5.5V VSSOP-10-0.5mm Analog to Digital Converters (ADC) RoHS | YES | 5 | 10388 | 5.19
C2761457 | AS0BC21-S48BE-7H | FOXCONN |  | SMD,P=0.5mm,Surface Mount,Right Angle | 67P Surface Mount, Right Angle SMD,P=0.5mm,Surface Mount,Right Angle Centronics Connectors RoHS | YES | 5 | 0.9805 | 4.90
C2761526 | AS0BC21-S40BB-7H | FOXCONN |  | SMD,P=0.5mm,Surface Mount,Right Angle | 67P Surface Mount, Right Angle SMD,P=0.5mm,Surface Mount,Right Angle Centronics Connectors RoHS | YES | 20 | 0.3079 | 6.16
C512395 | EVQP2P02W | PANASONIC |  | SMD,4.7x3.5mm | Tactile Switch SPST 1N 2.5mm J-Lead 4.7mm x 3.5mm Surface Mount | YES | 30 | 0.2288 | 6.86
C2827654 | USBLC6-2SC6 | TECH PUBLIC |  | SOT-23-6 | 12VC Clamp 6A Ipp ESD DIODE SOT-23-6 | YES | 10 | 0.0334 | 0.33
C144198 | MCP4725A0T-E/CH | MICROCHIP |  | SOT-23-6 | 6us 2.7V~5.5V 2LSB I2C SOT-23-6 Digital to Analog Converters (DAC) RoHS | YES | 3 | 0.8004 | 2.40
C7813 | SN74LVC125APWR | TI |  | TSSOP-14 | 1.65V~3.6V 1 4 2.5ns@3.3V,50pF 40uA TSSOP-14 Buffers, Drivers, Receivers, Transceivers RoHS | YES | 5 | 0.1412 | 0.71
C393941 | TF PUSH | SHOU HAN |  | SMD | Micro SD card (TF card) Connector and Ejector Push-Push Surface Mount | YES | 10 | 0.0509 | 0.51
C2765186 | TYPE-C 16PIN 2MD(073) | SHOU HAN |  | SMD | USB-C (USB TYPE-C) Receptacle Connector 16 Position Surface Mount, Right Angle | YES | 20 | 0.0505 | 1.01
C2976072 | WS2812C-2020-V1 | Worldsemi |  | SMD,2x2mm | SMD,2x2mm LED Addressable, Specialty RoHS | YES | 50 | 0.0528 | 2.64
