ItsNotDaan/BodyTempSensor/KiCad/BodyTempSensor.kicad_pcb

## KiCad design KiCad/BodyTempSensor.kicad_pcb (2026-06-18)

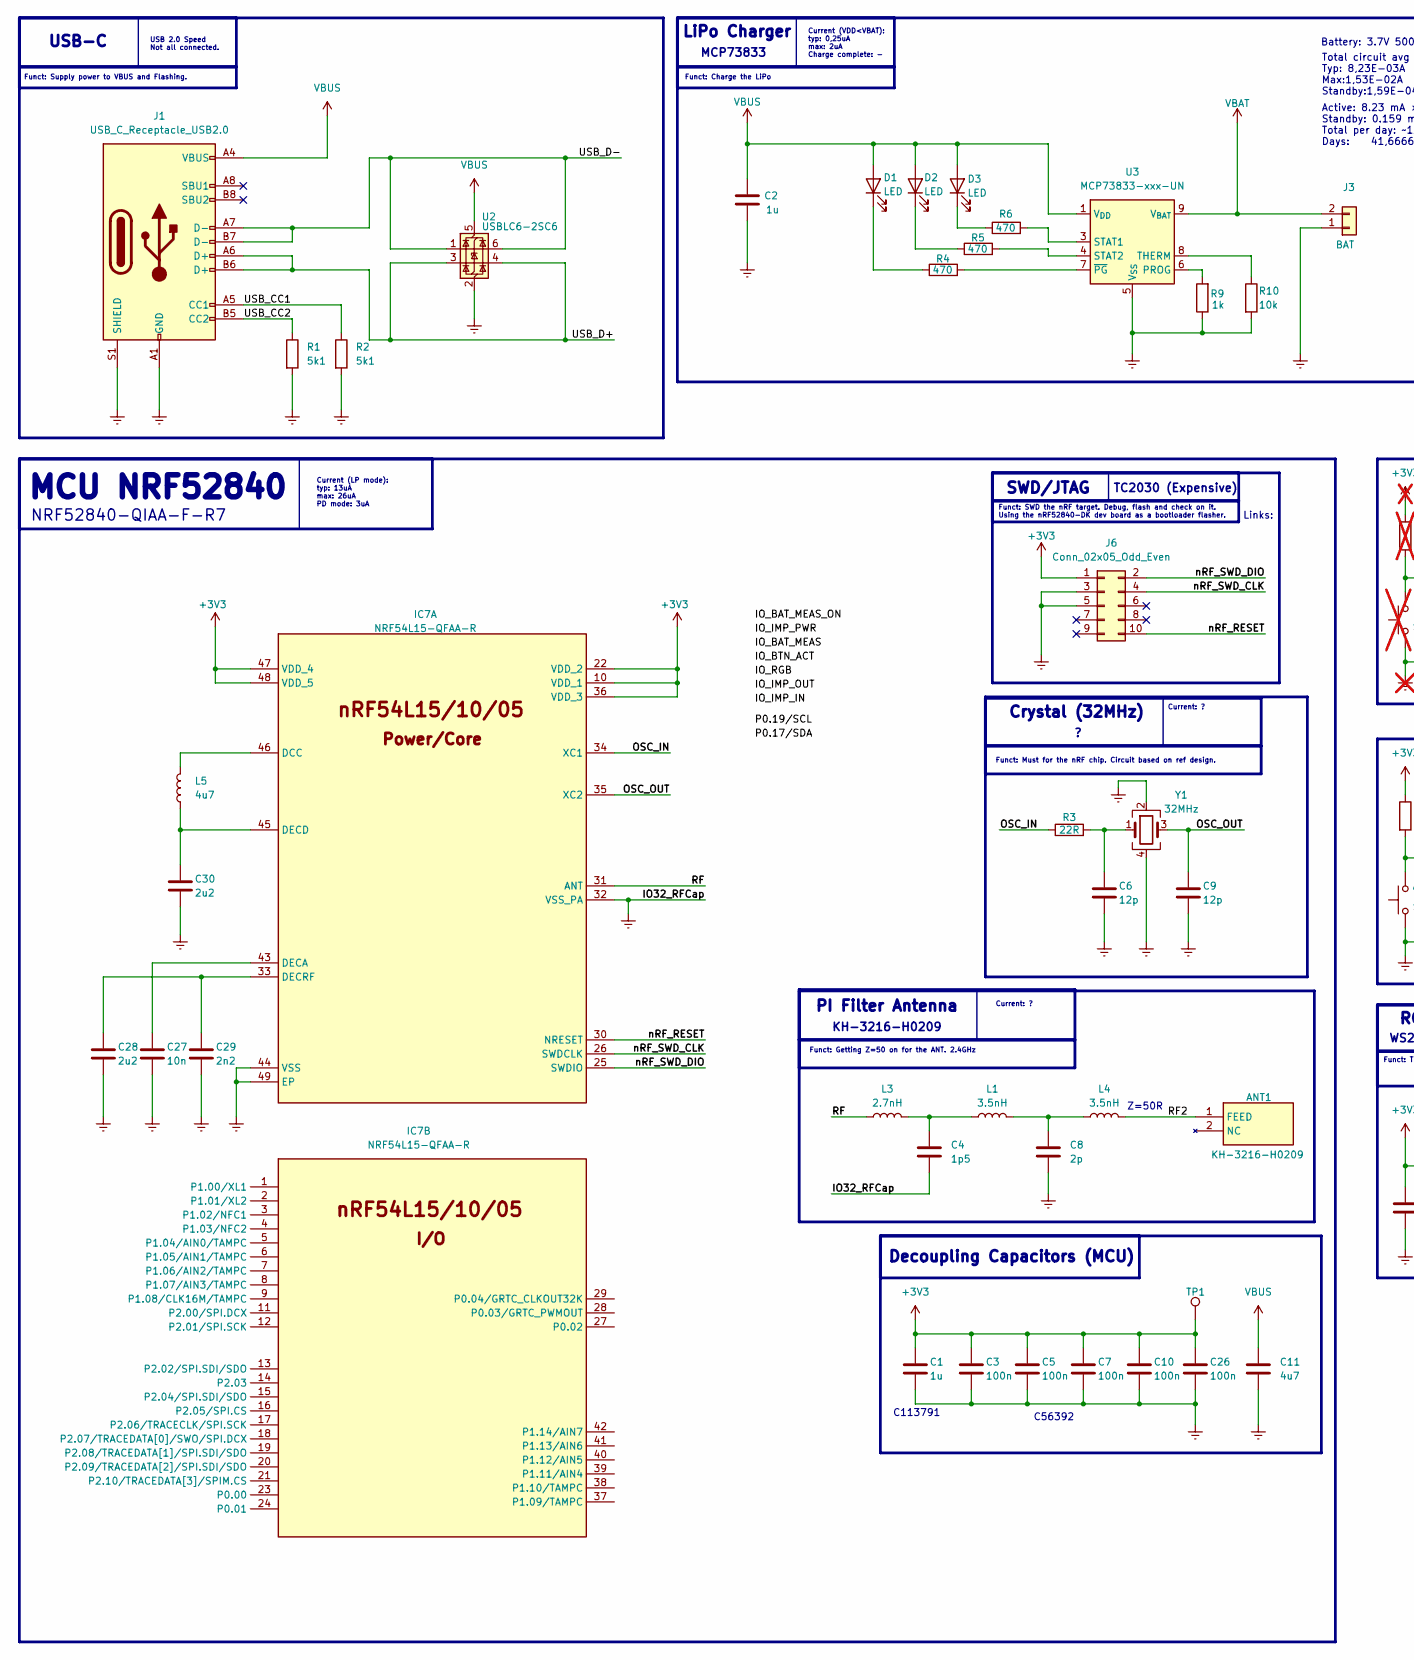
[picture p1: schematic BodyTempSensor.kicad_sch, part in row 1, column 1]

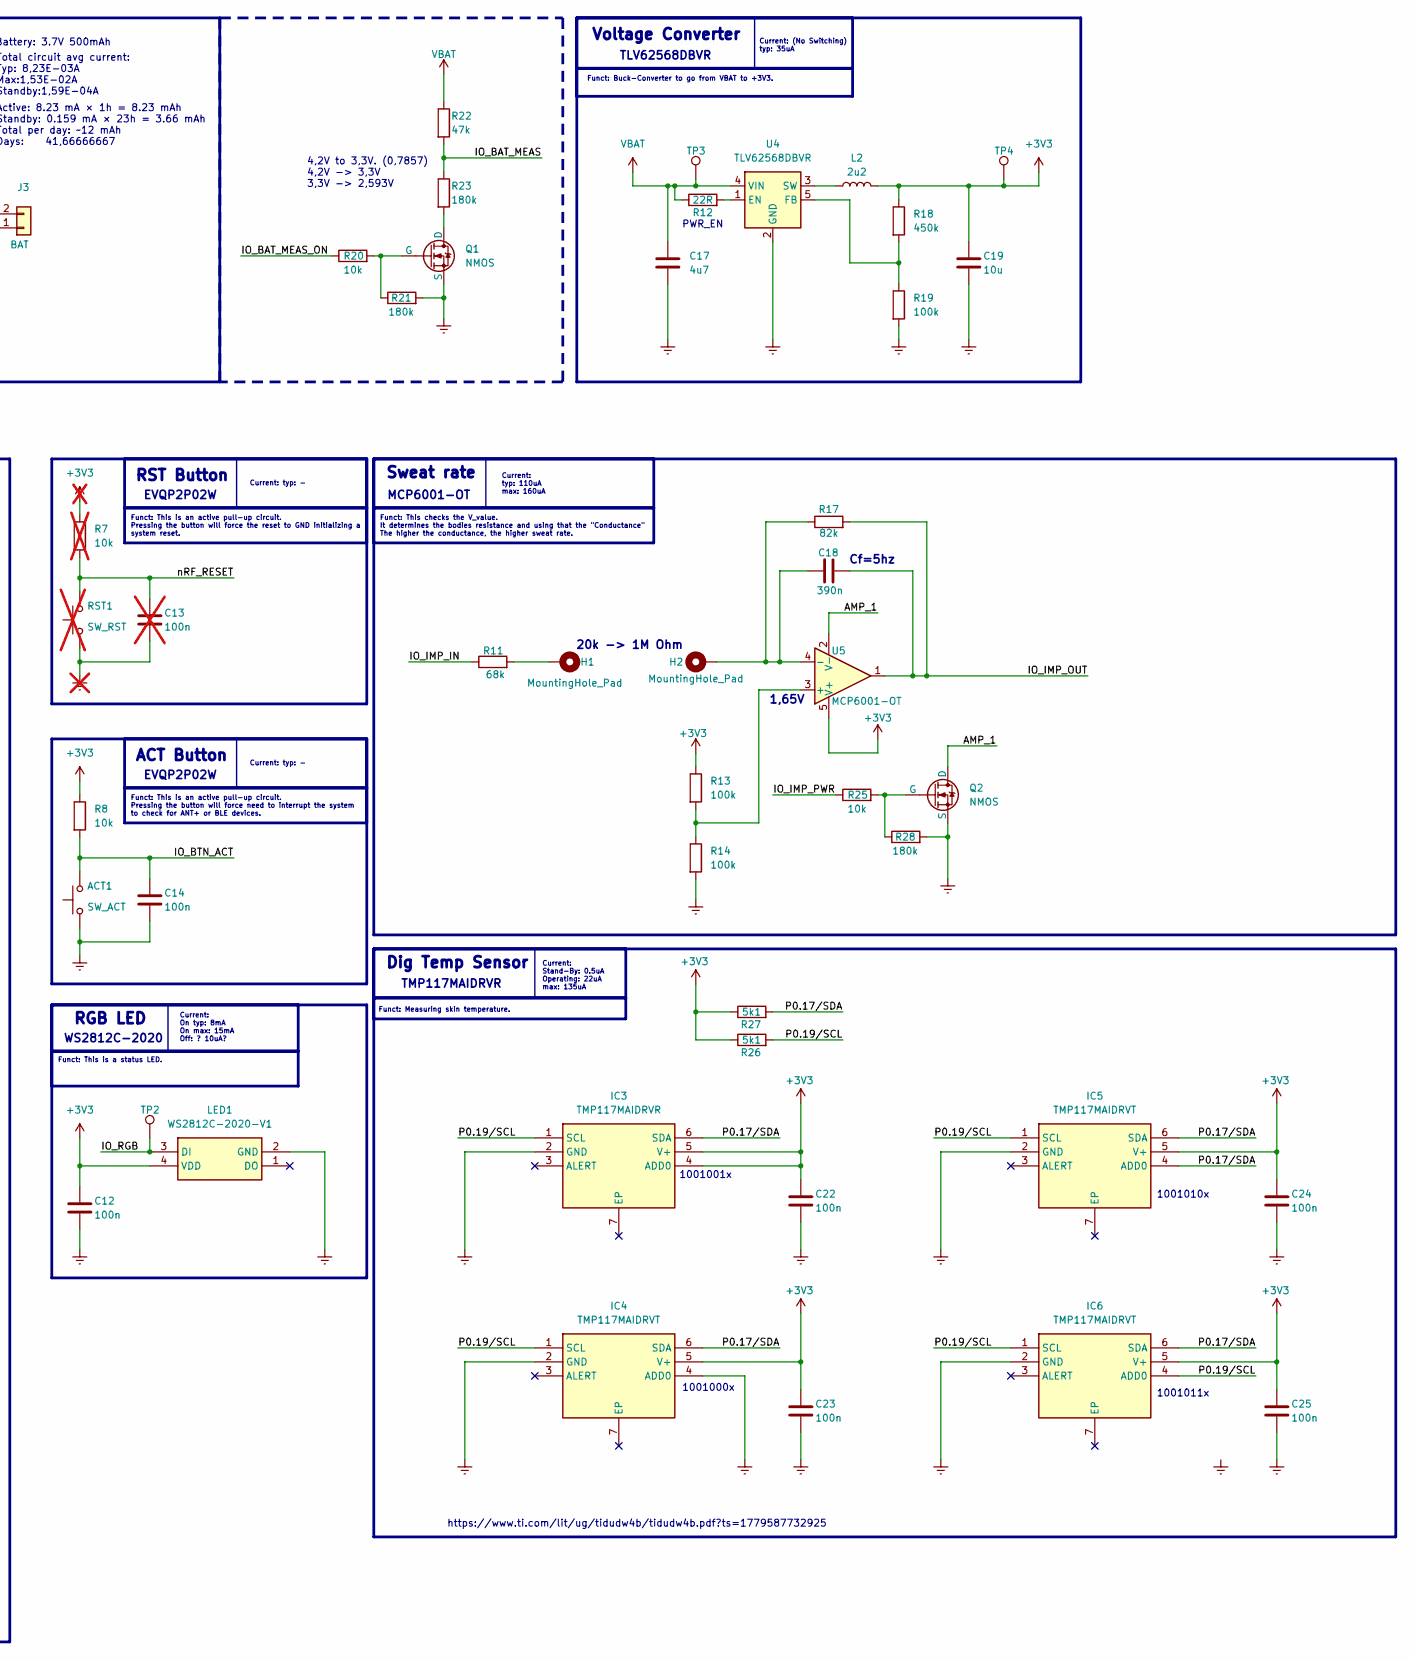
[picture p2: schematic BodyTempSensor.kicad_sch, part in row 1, column 2]

Parts:
ACT1: SW_ACT; SW_SPST_EVQP2; Manufacturer_Part_Number EVQP2P02W; LCSC PART # C512395
ANT1: KH-3216-H0209; ANTC3216X140N; Manufacturer_Part_Number KH-3216-H0209; LCSC PART # C2925417
C1: 1u; C_0402_1005Metric_Pad0.74x0.62mm_HandSolder; Manufacturer_Part_Number CC0402MRX5R6BB105; LCSC PART # C113791
C2: 1u; C_0504_1310Metric_Pad0.83x1.28mm_HandSolder
C3, C5, C7, C10, C12, C14, C22, C23, C24, C25, C26: 100n; C_0402_1005Metric_Pad0.74x0.62mm_HandSolder; Manufacturer_Part_Number C1005X5R1E104KT000E; LCSC PART # C361203
C4: 1p5; C_0402_1005Metric_Pad0.74x0.62mm_HandSolder
C6, C9: 12p; C_0402_1005Metric_Pad0.74x0.62mm_HandSolder
C8: 2p; C_0402_1005Metric_Pad0.74x0.62mm_HandSolder
C11, C17: 4u7; C_0402_1005Metric_Pad0.74x0.62mm_HandSolder; Manufacturer_Part_Number GRM155R60J475ME47D; LCSC PART # C82453
C13: 100n; C_0402_1005Metric_Pad0.74x0.62mm_HandSolder; Manufacturer_Part_Number C1005X5R1E104KT000E; LCSC PART # C361203; not fitted
C18: 390n; C_0402_1005Metric_Pad0.74x0.62mm_HandSolder
C19: 10u; C_0402_1005Metric_Pad0.74x0.62mm_HandSolder; Manufacturer_Part_Number 0402X106M100CT; LCSC PART # C2992625
C27: 10n; C_0402_1005Metric_Pad0.74x0.62mm_HandSolder
C28, C30: 2u2; C_0402_1005Metric_Pad0.74x0.62mm_HandSolder
C29: 2n2; C_0402_1005Metric_Pad0.74x0.62mm_HandSolder
D1, D2, D3: LED; LED_0603_1608Metric_Pad1.05x0.95mm_HandSolder
H1, H2: MountingHole_Pad; MountingHole_2.2mm_M2_DIN965_Pad
IC3: TMP117MAIDRVR; SON65P200X200X80-7N; Manufacturer_Part_Number TMP117MAIDRVT; Mouser Part Number 595-TMP117MAIDRVT
IC4, IC5, IC6: TMP117MAIDRVT; SON65P200X200X80-7N; Manufacturer_Part_Number TMP117MAIDRVT; Mouser Part Number 595-TMP117MAIDRVT
IC7: NRF54L15-QFAA-R; QFN40P600X600X95-49N; Manufacturer_Part_Number NRF54L15-QFAA-R; Mouser Part Number 949-NRF54L15-QFAA-R
J1: USB_C_Receptacle_USB2.0; USB_C_Receptacle_GCT_USB4105-xx-A_16P_TopMnt_Horizontal
J3: BAT; PinSocket_1x02_P2.54mm_Vertical
J6: Conn_02x05_Odd_Even; PinHeader_2x05_P1.27mm_Vertical
L1, L4: 3.5nH; L_0201_0603Metric; Manufacturer_Part_Number LQP03HQ3N5B02
L2: 2u2; L_Wurth_WE-LQSH-4020; Manufacturer_Part_Number SMNR4020-2.2UH; LCSC PART # C135262
L3: 2.7nH; L_0201_0603Metric; Manufacturer_Part_Number LQP03HQ2N7B02
L5: 4u7; L_0201_0603Metric
LED1: WS2812C-2020-V1; WS2812C2020; Manufacturer_Part_Number WS2812C-2020; LCSC PART # C2976072
Q1, Q2: NMOS
R1, R2, R26, R27: 5k1; R_0402_1005Metric_Pad0.72x0.64mm_HandSolder
R3, R12: 22R; R_0402_1005Metric_Pad0.72x0.64mm_HandSolder; Manufacturer_Part_Number ERJ2RKF22R0X; LCSC PART # C413049
R4, R5, R6: 470; R_0402_1005Metric_Pad0.72x0.64mm_HandSolder
R7: 10k; R_0402_1005Metric_Pad0.72x0.64mm_HandSolder; Manufacturer_Part_Number WR04X1002FTL; LCSC PART # C163810; not fitted
R8, R10, R20, R25: 10k; R_0402_1005Metric_Pad0.72x0.64mm_HandSolder; Manufacturer_Part_Number WR04X1002FTL; LCSC PART # C163810
R9: 1k; R_0402_1005Metric_Pad0.72x0.64mm_HandSolder
R11: 68k; R_0402_1005Metric_Pad0.72x0.64mm_HandSolder
R13, R14, R19: 100k; R_0402_1005Metric_Pad0.72x0.64mm_HandSolder; Manufacturer_Part_Number RT0402CRE07100KL; LCSC PART # C705662
R17: 82k; R_0402_1005Metric_Pad0.72x0.64mm_HandSolder
R18: 450k; R_0402_1005Metric_Pad0.72x0.64mm_HandSolder; Manufacturer_Part_Number FRC0402F4503TS; LCSC PART # C5159688
R21, R23, R28: 180k; R_0402_1005Metric_Pad0.72x0.64mm_HandSolder
R22: 47k; R_0402_1005Metric_Pad0.72x0.64mm_HandSolder
RST1: SW_RST; SW_SPST_EVQP2; Manufacturer_Part_Number EVQP2P02W; LCSC PART # C512395; not fitted
TP1, TP2, TP3, TP4: TestPoint; TestPoint_Pad_D1.0mm
U2: USBLC6-2SC6; SOT-23-6
U3: MCP73833-xxx-UN; MSOP-10_3x3mm_P0.5mm
U4: TLV62568DBVR; SOT-23-5; Manufacturer_Part_Number TLV62568DBVR; LCSC PART # C163219
U5: MCP6001-OT; SOT-23-5
Y1: 32MHz; Crystal_SMD_3225-4Pin_3.2x2.5mm

Connections:
+3V3: C1.1, C3.1, C5.1, C7.1, C10.1, C12.1, C19.1, C22.1, C23.1, C24.1, C25.1, C26.1, IC3.4 (ADD0), IC3.5 (V+), IC4.5 (V+), IC5.5 (V+), IC6.5 (V+), IC7.10 (VDD_1), IC7.22 (VDD_2), IC7.36 (VDD_3), IC7.47 (VDD_4), IC7.48 (VDD_5), J6.1, L2.2, LED1.4 (VDD), R7.1, R8.1, R13.1, R18.1, R26.1, R27.1, TP1.1 (1_1), TP4.1 (1_1), U5.5 (V+)
/AMP_1: Q2.1 (D), U5.2 (V-)
/IO_BAT_MEAS: R22.2, R23.1
/IO_BAT_MEAS_ON: R20.1
/IO_BTN_ACT: ACT1.2, C14.1, R8.2
/IO_IMP_IN: R11.1
/IO_IMP_OUT: C18.2, R17.2, U5.1
/IO_IMP_PWR: R25.1
/IO_RGB: LED1.3 (DI), TP2.1 (1_1)
/OSC_IN: IC7.34 (XC1), R3.1
/OSC_OUT: C9.1, IC7.35 (XC2), Y1.3
/P0.17/SDA: IC3.6 (SDA), IC4.6 (SDA), IC5.4 (ADD0), IC5.6 (SDA), IC6.6 (SDA), R27.2
/P0.19/SCL: IC3.1 (SCL), IC4.1 (SCL), IC5.1 (SCL), IC6.1 (SCL), IC6.4 (ADD0), R26.2
/RF: IC7.31 (ANT), L3.1
/RF2: ANT1.1 (FEED_1), L4.2
/USB_CC1: J1.A5 (CC1), R2.1
/USB_CC2: J1.B5 (CC2), R1.1
/USB_D+: J1.A6 (D+), J1.B6 (D+), U2.3 (I/O2), U2.4 (I/O2)
/USB_D-: J1.A7 (D-), J1.B7 (D-), U2.1 (I/O1), U2.6 (I/O1)
/nRF_RESET: C13.1, IC7.30 (NRESET), J6.10, R7.2, RST1.2
/nRF_SWD_CLK: IC7.26 (SWDCLK), J6.4
/nRF_SWD_DIO: IC7.25 (SWDIO), J6.2
Earth: ACT1.1, C1.2, C2.1, C3.2, C4.2, C5.2, C6.2, C7.2, C8.2, C9.2, C10.2, C11.2, C12.2, C13.2, C14.2, C17.2, C19.2, C22.2, C23.2, C24.2, C25.2, C26.2, C27.2, C28.2, C29.2, C30.2, IC3.2 (GND), IC4.2 (GND), IC4.4 (ADD0), IC5.2 (GND), IC6.2 (GND), IC7.32 (VSS_PA), IC7.44 (VSS), IC7.49 (EP), J1.A1 (GND), J1.A12 (GND), J1.B1 (GND), J1.B12 (GND), J1.S1 (SHIELD), J3.1, J6.3, J6.5, LED1.2 (GND), Q1.3 (S), Q2.3 (S), R1.2, R2.2, R9.1, R10.2, R14.2, R19.2, R21.2, R28.2, RST1.1, U2.2 (GND), U3.5 (V_{SS}), U4.2 (GND), Y1.2, Y1.4
unnamed: C4.1, L1.1, L3.2
unnamed: C6.1, R3.2, Y1.1
unnamed: C8.1, L1.2, L4.1
unnamed: D1.1 (K), R4.1
unnamed: D2.1 (K), R5.1
unnamed: D3.1 (K), R6.1
unnamed: H1.1 (1_1), R11.2
unnamed: IC7.46 (DCC), L5.2
unnamed: C27.1, IC7.43 (DECA)
unnamed: C30.1, IC7.45 (DECD), L5.1
unnamed: C28.1, C29.1, IC7.33 (DECRF)
unnamed: Q1.1 (D), R23.2
unnamed: Q1.2 (G), R20.2, R21.1
unnamed: Q2.2 (G), R25.2, R28.1
unnamed: R9.2, U3.6 (PROG)
unnamed: R6.2, U3.3 (STAT1)
unnamed: R5.2, U3.4 (STAT2)
unnamed: R10.1, U3.8 (THERM)
unnamed: R4.2, U3.7 (~PG)
unnamed: R12.2, U4.1 (EN)
unnamed: R18.2, R19.1, U4.5 (FB)
unnamed: L2.1, U4.3 (SW)
unnamed: R13.2, R14.1, U5.3 (+)
unnamed: C18.1, H2.1 (1_1), R17.1, U5.4 (-)
VBAT: C17.1, J3.2, R12.1, R22.1, TP3.1 (1_1), U3.9 (V_{BAT}), U3.10 (V_{BAT}), U4.4 (VIN)
VBUS: C2.2, C11.1, D1.2 (A), D2.2 (A), D3.2 (A), J1.A4 (VBUS), J1.A9 (VBUS), J1.B4 (VBUS), J1.B9 (VBUS), U2.5 (VBUS), U3.1 (V_{DD}), U3.2 (V_{DD})

Notes on the sheet:
https://www.ti.com/lit/ug/tidudw4b/tidudw4b.pdf?ts=1779587732925
NRF52840-QIAA-F-R7
EVQP2P02W
Funct: Must for the nRF chip. Circuit based on ref design.
Crystal (32MHz)
Funct: Supply power to VBUS and Flashing.
MCP73833
Current: ?
Funct: Measuring skin temperature.
Active: 8.23 mA × 1h = 8.23 mAh Standby: 0.159 mA × 23h = 3.66 mAh Total per day: ~12 mAh Days: 41,66666667
Funct: Buck-Converter to go from VBAT to +3V3.
1,65V
Current: typ: -
Sweat rate
TLV62568DBVR
RGB LED
MCP6001-OT
Current (LP mode): typ: 13uA max: 26uA PD mode: 3uA
Current: typ: 110uA max: 160uA
Current (VDD<VBAT): typ: 0,25uA max: 2uA Charge complete: -
20k -> 1M Ohm
Funct: This is an active pull-up circuit. Pressing the button will force need to interrupt the system to check for ANT+ or BLE devices.
Z=50R
C113791
TMP117MAIDRVR
C56392
Funct: SWD the nRF target. Debug, flash and check on it. Using the nRF52840-DK dev board as a bootloader flasher.
Battery: 3.7V 500mAh
Funct: Getting Z=50 on for the ANT. 2.4GHz
Funct: This is a status LED.
Voltage Converter
ACT Button
PI Filter Antenna
Current: On typ: 8mA On max: 15mA Off: ? 10uA?
LiPo Charger
Total circuit avg current: Typ: 8,23E-03A Max:1,53E-02A Standby:1,59E-04A
TC2030 (Expensive)
Decoupling Capacitors (MCU)
USB 2.0 Speed Not all connected.
SWD/JTAG
PWR_EN
KH-3216-H0209
1001000x
Funct: This checks the V_value. It determines the bodies resistance and using that the "Conductance" The higher the conductance, the higher sweat rate.
Current: Stand-By: 0.5uA Operating: 22uA max: 135uA
4,2V to 3,3V. (0,7857) 4,2V -> 3,3V 3,3V -> 2,593V
WS2812C-2020
MCU NRF52840
Cf=5hz
RST Button
USB-C
1001011x
Current: (No Switching) typ: 35uA
Links:
1001001x
Dig Temp Sensor
Funct: Charge the LiPo
1001010x
Funct: This is an active pull-up circuit. Pressing the button will force the reset to GND initializing a system reset.

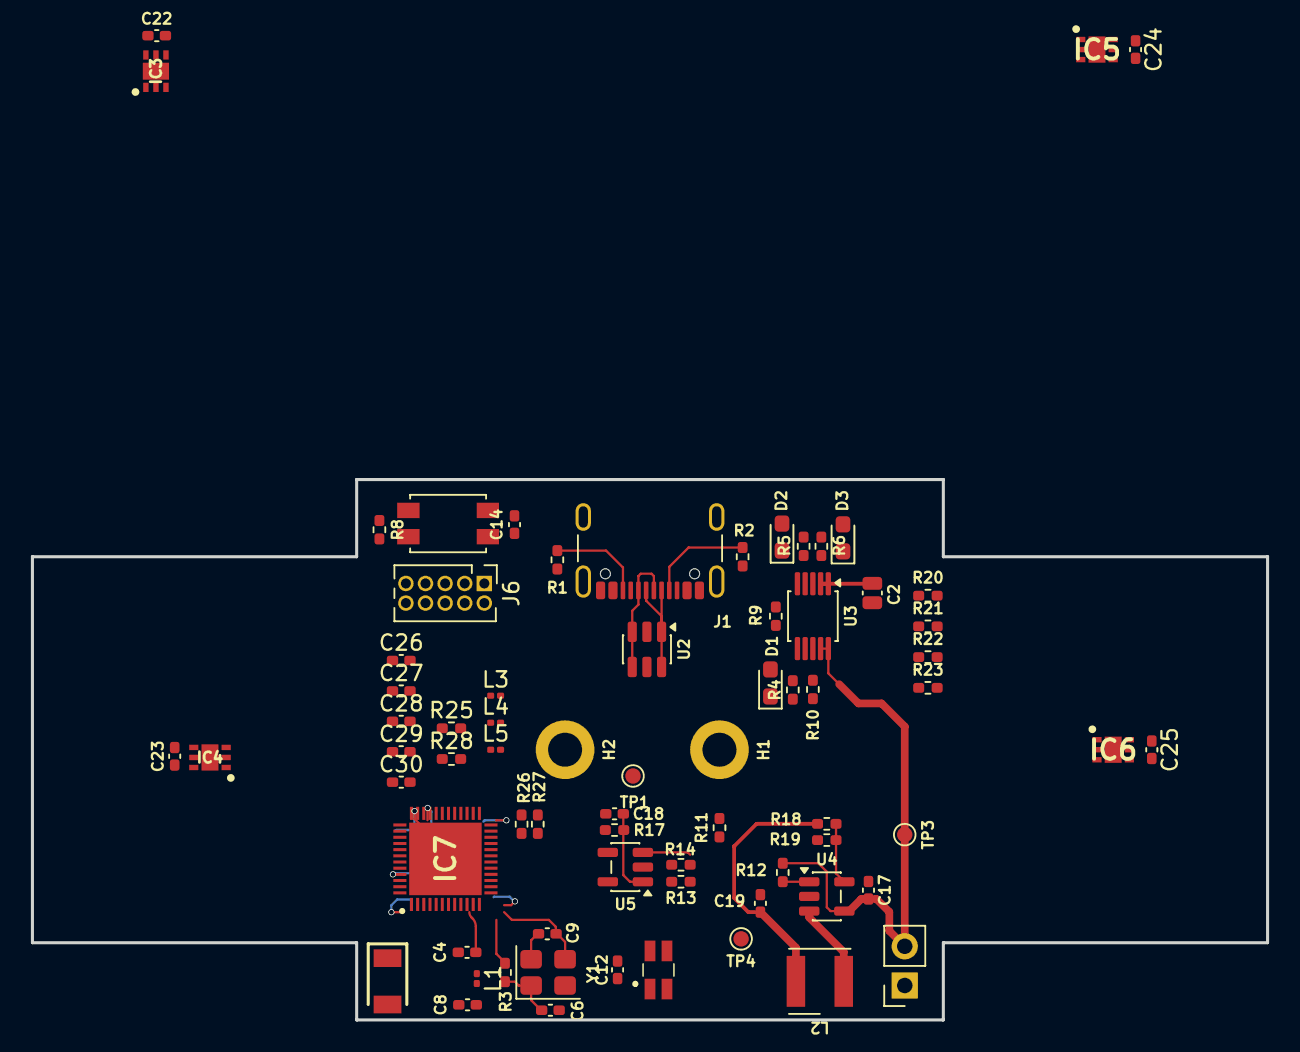
[picture p3: board BodyTempSensor.kicad_pcb from above]

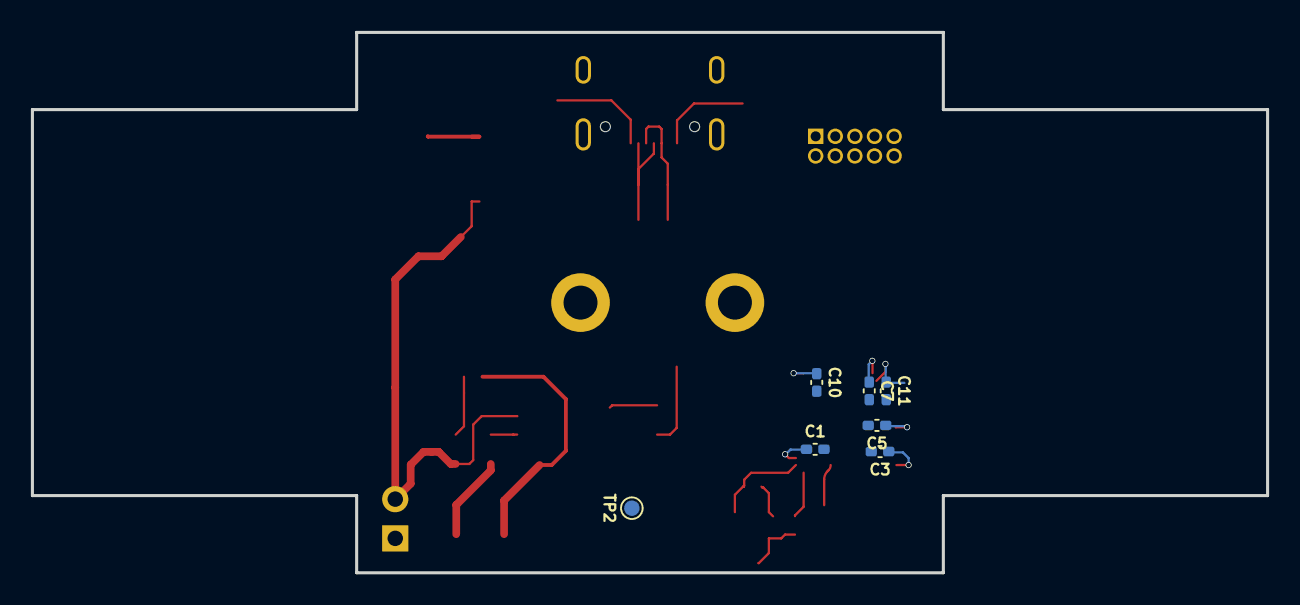
[picture p4: board BodyTempSensor.kicad_pcb from below]

Board: 4 copper layers, 80.0 x 35.0 mm, 79 parts (7 on the bottom side), 44 nets.
