ItsNotDaan/BodyTempSensor/(commit log)

2026-05-24 Initial commit: KiCad body temperature sensor project
    [BodyTempSensor.kicad_pcb, BodyTempSensor.kicad_sch, BodyTempSensor_Calculations.xlsx]
2026-05-25 Changed temp sensor, added components and created a general layout design
    [BodyTempSensor.kicad_pcb, BodyTempSensor.kicad_sch, BodyTempSensor_Calculations.xlsx]
2026-06-14 Add nRF54L15 biometric chest-strap firmware (NCS/Zephyr PoC)
    New Firmware/biometric-wearable NCS application: TMP117 heat-flux core-temp
    and EDA/GSR over ANT+ (primary) and a custom BLE GATT service (secondary).
    - One-module-one-responsibility layout (app/sensors/radio/hmi/util) with
    Doxygen-commented functions and file/section banners.
    - DK overlay for immediate bring-up; scaffolded custom board (bodytemp_wearable).
    - ANT broadcast guarded by CONFIG_ANT so BLE-only builds still link.
    - README documents version assumptions, ANT page + BLE characteristic tables,
    build/flash steps, and the deferred-work TODO list.
    https://claude.ai/code/session_01BgJHxLMvYSs5oXG7zoFzVa
2026-06-18 Add Bill of Materials (BOM) for Body Temperature Sensor project
    [BodyTempSens_Data.xlsx, BodyTempSensor.csv, BodyTempSensor.kicad_pcb, BodyTempSensor.kicad_sch, BodyTempSensor_Calculations.xlsx, Invertory BOM.xlsx]
